Multi-slope-ADC/PCB/bom/BOM-all.csv

Reference | Value | Footprint | Quantity | DNP | Manufacturer | Manufacturer Part Number | Datasheet | Jumper State | Assembly note
C1 | 100n | Capacitor_SMD:C_0805_2012Metric | 1 |  | KYOCERA AVX | 08055C104KAT2A | https://datasheets.kyocera-avx.com/X7RDielectric.pdf
C2 | 100n | Capacitor_SMD:C_0805_2012Metric | 1 |  | KYOCERA AVX | 08055C104KAT2A | https://datasheets.kyocera-avx.com/X7RDielectric.pdf
C3 | 100n | Capacitor_SMD:C_0805_2012Metric | 1 |  | KYOCERA AVX | 08055C104KAT2A | https://datasheets.kyocera-avx.com/X7RDielectric.pdf
C4 | 100n | Capacitor_SMD:C_0805_2012Metric | 1 |  | KYOCERA AVX | 08055C104KAT2A | https://datasheets.kyocera-avx.com/X7RDielectric.pdf
C5 | 100n | Capacitor_SMD:C_0805_2012Metric | 1 |  | KYOCERA AVX | 08055C104KAT2A | https://datasheets.kyocera-avx.com/X7RDielectric.pdf
C6 | 2.2u | Capacitor_SMD:C_0805_2012Metric | 1 | DNP | Samsung Electro-Mechanics | CL21B225KAFNNNE | https://product.samsungsem.com/mlcc/CL21B225KAFNNN.do
C7 | 100u | Capacitor_THT:CP_Radial_D8.0mm_P3.50mm | 1 |  | Panasonic | EEU-EB1J101 | https://industrial.panasonic.com/ww/products/pt/aluminum-cap-lead/models/EEUEB1J101
C8 | 100u | Capacitor_THT:CP_Radial_D8.0mm_P3.50mm | 1 |  | Panasonic | EEU-EB1J101 | https://industrial.panasonic.com/ww/products/pt/aluminum-cap-lead/models/EEUEB1J101
C9 | 100n | Capacitor_SMD:C_0805_2012Metric | 1 |  | KYOCERA AVX | 08055C104KAT2A | https://datasheets.kyocera-avx.com/X7RDielectric.pdf
C10 | 100n | Capacitor_SMD:C_0805_2012Metric | 1 |  | KYOCERA AVX | 08055C104KAT2A | https://datasheets.kyocera-avx.com/X7RDielectric.pdf
C11 | 2.2n | Capacitor_SMD:C_0805_2012Metric | 1 |  | TDK | C2012C0G1H222J085AA | https://product.tdk.com/en/search/capacitor/ceramic/mlcc/info?part_no=C2012C0G1H222J085AA
C12 | 100n | Capacitor_SMD:C_0805_2012Metric | 1 |  | KYOCERA AVX | 08055C104KAT2A | https://datasheets.kyocera-avx.com/X7RDielectric.pdf
C13 | 4.7u | Capacitor_THT:C_Rect_L7.2mm_W7.2mm_P5.00mm_FKS2_FKP2_MKS2_MKP2 | 1 |  | WIMA | MKS2C044701M00KSSD | https://www.wima.de/wp-content/uploads/media/e_WIMA_MKS_2.pdf
C14 | 220p | Capacitor_SMD:C_0805_2012Metric | 1 |  | Samsung Electro-Mechanics | CL21C221JBANNNC | https://product.samsungsem.com/mlcc/CL21C221JBANNN.do
C15 | 22p | Capacitor_SMD:C_0805_2012Metric | 1 |  | Samsung Electro-Mechanics | CL21C220JBANNNC | https://product.samsungsem.com/mlcc/CL21C220JBANNN.do |  | Original assembly: first of two parallel 22pF parts at C15; second part C211. Total 44pF, user confirmed.
C16 | 10n | Capacitor_SMD:C_0805_2012Metric | 1 |  | TDK | CGA4C2C0G1H103J060AA | https://product.tdk.com/en/search/capacitor/ceramic/mlcc/info?part_no=CGA4C2C0G1H103J060AA
C17 | 330p | Capacitor_SMD:C_0805_2012Metric | 1 |  | KEMET | C0805C331J5GACTU | https://content.kemet.com/datasheets/KEM_C1003_C0G_SMD.pdf
C18 | 100n | Capacitor_SMD:C_0805_2012Metric | 1 |  | KYOCERA AVX | 08055C104KAT2A | https://datasheets.kyocera-avx.com/X7RDielectric.pdf
C19 | 100n | Capacitor_SMD:C_0805_2012Metric | 1 |  | KYOCERA AVX | 08055C104KAT2A | https://datasheets.kyocera-avx.com/X7RDielectric.pdf
C20 | 100u | Capacitor_THT:CP_Radial_D8.0mm_P3.50mm | 1 |  | Panasonic | EEU-EB1J101 | https://industrial.panasonic.com/ww/products/pt/aluminum-cap-lead/models/EEUEB1J101
C21 | 220p | Capacitor_SMD:C_0805_2012Metric | 1 |  | Samsung Electro-Mechanics | CL21C221JBANNNC | https://product.samsungsem.com/mlcc/CL21C221JBANNN.do
C22 | 100u | Capacitor_THT:CP_Radial_D8.0mm_P3.50mm | 1 |  | Panasonic | EEU-EB1J101 | https://industrial.panasonic.com/ww/products/pt/aluminum-cap-lead/models/EEUEB1J101
C23 | 100u | Capacitor_THT:CP_Radial_D8.0mm_P3.50mm | 1 |  | Panasonic | EEU-EB1J101 | https://industrial.panasonic.com/ww/products/pt/aluminum-cap-lead/models/EEUEB1J101
C24 | 100n | Capacitor_SMD:C_0805_2012Metric | 1 |  | KYOCERA AVX | 08055C104KAT2A | https://datasheets.kyocera-avx.com/X7RDielectric.pdf
C25 | 100n | Capacitor_SMD:C_0805_2012Metric | 1 |  | KYOCERA AVX | 08055C104KAT2A | https://datasheets.kyocera-avx.com/X7RDielectric.pdf
C26 | 47n | Capacitor_SMD:C_0805_2012Metric | 1 |  | KEMET | C0805C473K3GECAUTO | https://content.kemet.com/datasheets/KEM_C1022_C0G_AUTO_SMD.pdf
C27 | 100n | Capacitor_SMD:C_0805_2012Metric | 1 |  | KYOCERA AVX | 08055C104KAT2A | https://datasheets.kyocera-avx.com/X7RDielectric.pdf
C28 | 47n | Capacitor_SMD:C_0805_2012Metric | 1 |  | KEMET | C0805C473K3GECAUTO | https://content.kemet.com/datasheets/KEM_C1022_C0G_AUTO_SMD.pdf
C29 | 220p | Capacitor_SMD:C_0805_2012Metric | 1 |  | Samsung Electro-Mechanics | CL21C221JBANNNC | https://product.samsungsem.com/mlcc/CL21C221JBANNN.do
C30 | 1n | Capacitor_SMD:C_0805_2012Metric | 1 |  | Wurth Elektronik | 885012007063 | https://www.we-online.com/components/products/datasheet/885012007063.pdf
C31 | 100n | Capacitor_SMD:C_0805_2012Metric | 1 |  | KEMET | C0805C473K3GECAUTO | https://content.kemet.com/datasheets/KEM_C1022_C0G_AUTO_SMD.pdf
C32 | 100n | Capacitor_SMD:C_0805_2012Metric | 1 |  | KYOCERA AVX | 08055C104KAT2A | https://datasheets.kyocera-avx.com/X7RDielectric.pdf
C33 | 100n | Capacitor_SMD:C_0805_2012Metric | 1 |  | KYOCERA AVX | 08055C104KAT2A | https://datasheets.kyocera-avx.com/X7RDielectric.pdf
C34 | 100n | Capacitor_SMD:C_0805_2012Metric | 1 |  | KYOCERA AVX | 08055C104KAT2A | https://datasheets.kyocera-avx.com/X7RDielectric.pdf
C35 | 100n | Capacitor_SMD:C_0805_2012Metric | 1 |  | KYOCERA AVX | 08055C104KAT2A | https://datasheets.kyocera-avx.com/X7RDielectric.pdf
C36 | 100n | Capacitor_SMD:C_0805_2012Metric | 1 |  | KYOCERA AVX | 08055C104KAT2A | https://datasheets.kyocera-avx.com/X7RDielectric.pdf
C37 | 1n | Capacitor_SMD:C_0805_2012Metric | 1 | DNP | Wurth Elektronik | 885012007063 | https://www.we-online.com/components/products/datasheet/885012007063.pdf
C38 | 100n | Capacitor_SMD:C_0805_2012Metric | 1 |  | KYOCERA AVX | 08055C104KAT2A | https://datasheets.kyocera-avx.com/X7RDielectric.pdf
C39 | 100n | Capacitor_SMD:C_0805_2012Metric | 1 |  | KYOCERA AVX | 08055C104KAT2A | https://datasheets.kyocera-avx.com/X7RDielectric.pdf
C40 | 100n | Capacitor_SMD:C_0805_2012Metric | 1 |  | KYOCERA AVX | 08055C104KAT2A | https://datasheets.kyocera-avx.com/X7RDielectric.pdf
C41 | 100n | Capacitor_SMD:C_0805_2012Metric | 1 |  | KYOCERA AVX | 08055C104KAT2A | https://datasheets.kyocera-avx.com/X7RDielectric.pdf
C42 | 100n | Capacitor_SMD:C_0805_2012Metric | 1 |  | KYOCERA AVX | 08055C104KAT2A | https://datasheets.kyocera-avx.com/X7RDielectric.pdf
C43 | 100n | Capacitor_SMD:C_0805_2012Metric | 1 |  | KYOCERA AVX | 08055C104KAT2A | https://datasheets.kyocera-avx.com/X7RDielectric.pdf
C44 | 100u | Capacitor_THT:CP_Radial_D8.0mm_P3.50mm | 1 |  | Panasonic | EEU-EB1J101 | https://industrial.panasonic.com/ww/products/pt/aluminum-cap-lead/models/EEUEB1J101
C45 | 100n | Capacitor_SMD:C_0805_2012Metric | 1 |  | KYOCERA AVX | 08055C104KAT2A | https://datasheets.kyocera-avx.com/X7RDielectric.pdf
C46 | 47n | Capacitor_SMD:C_0805_2012Metric | 1 |  | KEMET | C0805C473K3GECAUTO | https://content.kemet.com/datasheets/KEM_C1022_C0G_AUTO_SMD.pdf
C47 | 10n | Capacitor_SMD:C_0805_2012Metric | 1 |  | TDK | CGA4C2C0G1H103J060AA | https://product.tdk.com/en/search/capacitor/ceramic/mlcc/info?part_no=CGA4C2C0G1H103J060AA
C48 | 100n | Capacitor_SMD:C_0805_2012Metric | 1 |  | KYOCERA AVX | 08055C104KAT2A | https://datasheets.kyocera-avx.com/X7RDielectric.pdf
C49 | 100n | Capacitor_SMD:C_0805_2012Metric | 1 |  | KYOCERA AVX | 08055C104KAT2A | https://datasheets.kyocera-avx.com/X7RDielectric.pdf
C50 | 100n | Capacitor_SMD:C_0805_2012Metric | 1 |  | KYOCERA AVX | 08055C104KAT2A | https://datasheets.kyocera-avx.com/X7RDielectric.pdf
C51 | 100n | Capacitor_SMD:C_0805_2012Metric | 1 |  | KYOCERA AVX | 08055C104KAT2A | https://datasheets.kyocera-avx.com/X7RDielectric.pdf
C201 | 100n | Capacitor_SMD:C_0805_2012Metric | 1 |  | KYOCERA AVX | 08055C104KAT2A | https://datasheets.kyocera-avx.com/X7RDielectric.pdf
C202 | 100u | Capacitor_THT:CP_Radial_D8.0mm_P3.50mm | 1 |  | Panasonic | EEU-EB1J101 | https://industrial.panasonic.com/ww/products/pt/aluminum-cap-lead/models/EEUEB1J101
C203 | 100n | Capacitor_SMD:C_0805_2012Metric | 1 |  | KYOCERA AVX | 08055C104KAT2A | https://datasheets.kyocera-avx.com/X7RDielectric.pdf
C204 | 100u | Capacitor_THT:CP_Radial_D8.0mm_P3.50mm | 1 |  | Panasonic | EEU-EB1J101 | https://industrial.panasonic.com/ww/products/pt/aluminum-cap-lead/models/EEUEB1J101
C205 | 100n | Capacitor_SMD:C_0805_2012Metric | 1 |  | KYOCERA AVX | 08055C104KAT2A | https://datasheets.kyocera-avx.com/X7RDielectric.pdf
C206 | 100u | Capacitor_THT:CP_Radial_D8.0mm_P3.50mm | 1 |  | Panasonic | EEU-EB1J101 | https://industrial.panasonic.com/ww/products/pt/aluminum-cap-lead/models/EEUEB1J101
C207 | 100u | Capacitor_THT:CP_Radial_D8.0mm_P3.50mm | 1 |  | Panasonic | EEU-EB1J101 | https://industrial.panasonic.com/ww/products/pt/aluminum-cap-lead/models/EEUEB1J101
C209 | 100n | Capacitor_SMD:C_0805_2012Metric | 1 |  | KYOCERA AVX | 08055C104KAT2A | https://datasheets.kyocera-avx.com/X7RDielectric.pdf
C210 | 100n | Capacitor_SMD:C_0805_2012Metric | 1 |  | KYOCERA AVX | 08055C104KAT2A | https://datasheets.kyocera-avx.com/X7RDielectric.pdf
C211 | 22p | Capacitor_SMD:C_0805_2012Metric | 1 |  | Samsung Electro-Mechanics | CL21C220JBANNNC | https://product.samsungsem.com/mlcc/CL21C220JBANNN.do |  | Original assembly: second 22pF part physically added in parallel at C15. No dedicated PCB footprint; C15 + C211 = 44pF, user confirmed.
D1 | 12V | Diode_SMD:D_SOD-323 | 1 |  | Diodes Incorporated | DDZ12CSF-7 | https://www.diodes.com/part/view/DDZ12CSF
D3 | 1N4148 | Diode_SMD:D_SOD-323 | 1 |  | onsemi | 1N4148WS | https://www.onsemi.com/pdf/datasheet/1n4148ws-d.pdf
D4 | 5.6V | Diode_SMD:D_SOD-323 | 1 |  | onsemi | MM3Z5V6ST1G | https://www.onsemi.com/download/data-sheet/pdf/mm3z2v4st1-d.pdf
D5 | 1N4148 | Diode_SMD:D_SOD-323 | 1 |  | onsemi | 1N4148WS | https://www.onsemi.com/pdf/datasheet/1n4148ws-d.pdf
D6 | 5.6V | Diode_SMD:D_SOD-323 | 1 |  | onsemi | MM3Z5V6ST1G | https://www.onsemi.com/download/data-sheet/pdf/mm3z2v4st1-d.pdf
D7 | 12V | Diode_SMD:D_SOD-323 | 1 |  | Diodes Incorporated | DDZ12CSF-7 | https://www.diodes.com/part/view/DDZ12CSF
D8 | 1N4148 | Diode_SMD:D_SOD-323 | 1 |  | onsemi | 1N4148WS | https://www.onsemi.com/pdf/datasheet/1n4148ws-d.pdf
D9 | 5.6V | Diode_SMD:D_SOD-323 | 1 |  | onsemi | MM3Z5V6ST1G | https://www.onsemi.com/download/data-sheet/pdf/mm3z2v4st1-d.pdf
D11 | 1N4148 | Diode_SMD:D_SOD-323 | 1 |  | onsemi | 1N4148WS | https://www.onsemi.com/pdf/datasheet/1n4148ws-d.pdf
D12 | 1N4148 | Diode_SMD:D_SOD-323 | 1 |  | onsemi | 1N4148WS | https://www.onsemi.com/pdf/datasheet/1n4148ws-d.pdf
D13 | 1N4148 | Diode_SMD:D_SOD-323 | 1 |  | onsemi | 1N4148WS | https://www.onsemi.com/pdf/datasheet/1n4148ws-d.pdf
D14 | 1N4148 | Diode_SMD:D_SOD-323 | 1 |  | onsemi | 1N4148WS | https://www.onsemi.com/pdf/datasheet/1n4148ws-d.pdf
D15 | BAV199 | Package_TO_SOT_SMD:SOT-23 | 1 |  | onsemi | BAV199LT1G | https://www.onsemi.com/pdf/datasheet/bav199lt1-d.pdf
D18 | 1N4148 | Diode_SMD:D_SOD-323 | 1 |  | onsemi | 1N4148WS | https://www.onsemi.com/pdf/datasheet/1n4148ws-d.pdf
D19 | 1N4148 | Diode_SMD:D_SOD-323 | 1 |  | onsemi | 1N4148WS | https://www.onsemi.com/pdf/datasheet/1n4148ws-d.pdf
D201 | 1N4148 | Diode_SMD:D_SOD-323 | 1 |  | onsemi | 1N4148WS | https://www.onsemi.com/pdf/datasheet/1n4148ws-d.pdf
D202 | 1N4148 | Diode_SMD:D_SOD-323 | 1 |  | onsemi | 1N4148WS | https://www.onsemi.com/pdf/datasheet/1n4148ws-d.pdf
D203 | 1N4148WS |  | 1 |  | onsemi | 1N4148WS | https://www.onsemi.com/pdf/datasheet/1n4148ws-d.pdf |  | Hand-added original Q8 replacement, no dedicated PCB footprint. Connection by original Q8 pads and wire.
D204 | 1N4148WS |  | 1 |  | onsemi | 1N4148WS | https://www.onsemi.com/pdf/datasheet/1n4148ws-d.pdf |  | Hand-added original Q8 replacement, no dedicated PCB footprint. Connection by original Q8 pads and wire.
D205 | 1N4148 |  | 1 |  |  | 1N4148 | https://www.onsemi.com/download/data-sheet/pdf/1n914-d.pdf |  | Original additional 1N4148 near the voltage regulators with long leads: A to +5V, K to +15V. Type and orientation documented by the user on 2026-09-22. Manufacturer and ordering variant unknown; the datasheet is a manufacturer family reference and does not establish an onsemi/TR part.
FB1 | Ferrite | Inductor_SMD:L_0805_2012Metric | 1 |  | TDK | MMZ2012Y152BT000 | https://product.tdk.com/en/system/files/dam/doc/product/emc/emc/beads/catalog/beads_commercial_signal_mmz2012_en.pdf
FB35 | Ferrite | Inductor_SMD:L_0805_2012Metric | 1 |  | TDK | MMZ2012Y152BT000 | https://product.tdk.com/en/system/files/dam/doc/product/emc/emc/beads/catalog/beads_commercial_signal_mmz2012_en.pdf
FB57 | Ferrite | Inductor_SMD:L_0805_2012Metric | 1 |  | TDK | MMZ2012Y152BT000 | https://product.tdk.com/en/system/files/dam/doc/product/emc/emc/beads/catalog/beads_commercial_signal_mmz2012_en.pdf
FB102 | Ferrite | Inductor_SMD:L_0805_2012Metric | 1 |  | TDK | MMZ2012Y152BT000 | https://product.tdk.com/en/system/files/dam/doc/product/emc/emc/beads/catalog/beads_commercial_signal_mmz2012_en.pdf
FB103 | Ferrite | Inductor_SMD:L_0805_2012Metric | 1 |  | TDK | MMZ2012Y152BT000 | https://product.tdk.com/en/system/files/dam/doc/product/emc/emc/beads/catalog/beads_commercial_signal_mmz2012_en.pdf
J1 | UART | Connector_PinHeader_2.54mm:PinHeader_1x04_P2.54mm_Vertical | 1 |  |  |  |  |  | Fitted as explicitly specified by the user; generic pin header with no specific manufacturer or part number.
J2 | Input | Connector_PinHeader_2.54mm:PinHeader_2x05_P2.54mm_Vertical | 1 |  |  |  |  |  | Fitted as explicitly specified by the user; generic pin header with no specific manufacturer or part number.
J3 | ICSP6 | Connector_PinHeader_2.54mm:PinHeader_2x03_P2.54mm_Vertical | 1 |  |  |  |  |  | Fitted as explicitly specified by the user; generic pin header with no specific manufacturer or part number.
J4 | ISCP10 | Connector_PinHeader_2.54mm:PinHeader_2x05_P2.54mm_Vertical | 1 |  |  |  |  |  | Fitted as explicitly specified by the user; generic pin header with no specific manufacturer or part number.
J5 | Power | Connector_PinHeader_2.54mm:PinHeader_1x05_P2.54mm_Vertical | 1 |  |  |  |  |  | Fitted as explicitly specified by the user; generic pin header with no specific manufacturer or part number.
LSP6 | INTX | Connector_PinHeader_2.54mm:PinHeader_1x01_P2.54mm_Vertical | 1 |  |  |  |  |  | Fitted as explicitly specified by the user; generic pin header with no specific manufacturer or part number.
LSP7 | Input+ | Connector_PinHeader_2.54mm:PinHeader_1x01_P2.54mm_Vertical | 1 |  |  |  |  |  | Not fitted (DNP), explicitly confirmed by the user on 2026-10-04.
LSP8 | Input- | Connector_PinHeader_2.54mm:PinHeader_1x01_P2.54mm_Vertical | 1 |  |  |  |  |  | Not fitted (DNP), explicitly confirmed by the user on 2026-10-04.
LSP200 | BIAS | Connector_PinHeader_2.54mm:PinHeader_1x01_P2.54mm_Vertical | 1 |  |  |  |  |  | Fitted as explicitly specified by the user; generic pin header with no specific manufacturer or part number.
Q$2 | MMBFJ310LT1G | Package_TO_SOT_SMD:SOT-23 | 1 | DNP | onsemi | MMBFJ310LT1G | https://www.onsemi.com/download/data-sheet/pdf/mmbfj309lt1-d.pdf
Q1 | BC856A | Package_TO_SOT_SMD:SOT-23 | 1 |  | Nexperia | BC856A,215 | https://assets.nexperia.com/documents/data-sheet/BC856_BC857_BC858.pdf
Q2 | BAS21 | Package_TO_SOT_SMD:SOT-23 | 1 |  | ROHM | BAS21HMFHT116 | https://www.rohm.com/products/diodes/switching-diodes/automotive/bas21hmfh-product |  | Original Q2 position: BAS21 A=pad1,K=pad3. Pad2 externally tied to input copper but internally NC; passive NC pin documents metal only.
Q3 | BC856A | Package_TO_SOT_SMD:SOT-23 | 1 |  | Nexperia | BC856A,215 | https://assets.nexperia.com/documents/data-sheet/BC856_BC857_BC858.pdf
Q4 | BC856A | Package_TO_SOT_SMD:SOT-23 | 1 |  | Nexperia | BC856A,215 | https://assets.nexperia.com/documents/data-sheet/BC856_BC857_BC858.pdf
Q5 | BC856A | Package_TO_SOT_SMD:SOT-23 | 1 |  | Nexperia | BC856A,215 | https://assets.nexperia.com/documents/data-sheet/BC856_BC857_BC858.pdf
Q6 | BC856A | Package_TO_SOT_SMD:SOT-23 | 1 |  | Nexperia | BC856A,215 | https://assets.nexperia.com/documents/data-sheet/BC856_BC857_BC858.pdf
Q7 | BC847C | Package_TO_SOT_SMD:SOT-23 | 1 |  | onsemi | BC847CLT1G | https://www.onsemi.com/download/data-sheet/pdf/bc846alt1-d.pdf
Q9 | BC856A | Package_TO_SOT_SMD:SOT-23 | 1 | DNP | Nexperia | BC856A,215 | https://assets.nexperia.com/documents/data-sheet/BC856_BC857_BC858.pdf
R1 | 4K99 | Resistor_SMD:R_0805_2012Metric | 1 |  | Susumu | RR1220P-4991-D-M | https://www.susumu.co.jp/common/pdf/e_all.pdf
R2 | 4K99 | Resistor_SMD:R_0805_2012Metric | 1 |  | Susumu | RR1220P-4991-D-M | https://www.susumu.co.jp/common/pdf/e_all.pdf
R3 | 2.2K | Resistor_SMD:R_0805_2012Metric | 1 |  | Susumu | RR1220P-222-D | https://www.susumu.co.jp/common/pdf/e_all.pdf
R4 | 1K | Resistor_SMD:R_0805_2012Metric | 1 |  | Susumu | RR1220P-102-D | https://www.susumu.co.jp/common/pdf/e_all.pdf
R5 | 22K | Resistor_SMD:R_0805_2012Metric | 1 |  | Susumu | RR1220P-223-D | https://www.susumu.co.jp/common/pdf/e_all.pdf
R6 | 22K | Resistor_SMD:R_0805_2012Metric | 1 |  | Susumu | RR1220P-223-D | https://www.susumu.co.jp/common/pdf/e_all.pdf
R7 | 100 | Resistor_SMD:R_0805_2012Metric | 1 |  | Susumu | RR1220P-101-D | https://www.susumu.co.jp/common/pdf/e_all.pdf
R8 | 100K | Resistor_SMD:R_0805_2012Metric | 1 |  | Susumu | RR1220P-104-D | https://www.susumu.co.jp/common/pdf/e_all.pdf
R9 | 4K99 | Resistor_SMD:R_0805_2012Metric | 1 |  | Susumu | RR1220P-4991-D-M | https://www.susumu.co.jp/common/pdf/e_all.pdf
R10 | 6.8K | Resistor_SMD:R_0805_2012Metric | 1 |  | Susumu | RR1220P-682-D | https://www.susumu.co.jp/common/pdf/e_all.pdf
R11 | 1K | Resistor_SMD:R_0805_2012Metric | 1 |  | Susumu | RR1220P-102-D | https://www.susumu.co.jp/common/pdf/e_all.pdf
R12 | 4K99 | Resistor_SMD:R_0805_2012Metric | 1 |  | Susumu | RR1220P-4991-D-M | https://www.susumu.co.jp/common/pdf/e_all.pdf
R13 | 47K | Resistor_SMD:R_0805_2012Metric | 1 |  | Susumu | RR1220P-473-D | https://www.susumu.co.jp/common/pdf/e_all.pdf
R14 | 47K | Resistor_SMD:R_0805_2012Metric | 1 |  | Susumu | RR1220P-473-D | https://www.susumu.co.jp/common/pdf/e_all.pdf
R16 | 22K | Resistor_SMD:R_0805_2012Metric | 1 |  | Susumu | RR1220P-223-D | https://www.susumu.co.jp/common/pdf/e_all.pdf
R18 | 330K | Resistor_SMD:R_0805_2012Metric | 1 |  | Susumu | RR1220P-334-D | https://www.susumu.co.jp/common/pdf/e_all.pdf
R19 | 4.7K | Resistor_SMD:R_0805_2012Metric | 1 |  | Susumu | RR1220P-472-D | https://www.susumu.co.jp/common/pdf/e_all.pdf
R20 | 180R | Resistor_SMD:R_0805_2012Metric | 1 |  | Susumu | RR1220P-181-D | https://www.susumu.co.jp/common/pdf/e_all.pdf |  | Original: 180 Ohm fitted, confirmed by the user on 2026-10-04; part type as listed in the Mouser parts list.
R21 | 10R | Resistor_SMD:R_0805_2012Metric | 1 |  | Susumu | RR1220Q-100-D | https://www.susumu.co.jp/common/pdf/e_all.pdf
R22 | 4.7K | Resistor_SMD:R_0805_2012Metric | 1 |  | Susumu | RR1220P-472-D | https://www.susumu.co.jp/common/pdf/e_all.pdf
R24 | 22K | Resistor_SMD:R_0805_2012Metric | 1 |  | Susumu | RR1220P-223-D | https://www.susumu.co.jp/common/pdf/e_all.pdf
R25 | 330K | Resistor_SMD:R_0805_2012Metric | 1 |  | Susumu | RR1220P-334-D | https://www.susumu.co.jp/common/pdf/e_all.pdf
R26 | 10R | Resistor_SMD:R_0805_2012Metric | 1 |  | Susumu | RR1220Q-100-D | https://www.susumu.co.jp/common/pdf/e_all.pdf
R27 | 39R | Resistor_SMD:R_0805_2012Metric | 1 |  | Susumu | RR1220Q-390-D | https://www.susumu.co.jp/common/pdf/e_all.pdf
R28 | 470R | Resistor_SMD:R_0805_2012Metric | 1 |  | Susumu | RR1220P-471-D | https://www.susumu.co.jp/common/pdf/e_all.pdf
R29 | 100R | Resistor_SMD:R_0805_2012Metric | 1 |  | Susumu | RR1220P-101-D | https://www.susumu.co.jp/common/pdf/e_all.pdf
R30 | OPT | Resistor_SMD:R_0805_2012Metric | 1 | DNP |  |  | ~
R31 | 100R | Resistor_SMD:R_0805_2012Metric | 1 |  | Susumu | RR1220P-101-D | https://www.susumu.co.jp/common/pdf/e_all.pdf
R32 | 100R | Resistor_SMD:R_0805_2012Metric | 1 |  | Susumu | RR1220P-101-D | https://www.susumu.co.jp/common/pdf/e_all.pdf
R33 | 10R | Resistor_SMD:R_0805_2012Metric | 1 |  | Susumu | RR1220Q-100-D | https://www.susumu.co.jp/common/pdf/e_all.pdf
R34 | 68K | Resistor_SMD:R_0805_2012Metric | 1 |  | Susumu | RR1220P-683-D | https://www.susumu.co.jp/common/pdf/e_all.pdf
R35 | 4K99 | Resistor_SMD:R_0805_2012Metric | 1 |  | Susumu | RR1220P-4991-D-M | https://www.susumu.co.jp/common/pdf/e_all.pdf
R36 | 22K | Resistor_SMD:R_0805_2012Metric | 1 |  | Susumu | RR1220P-223-D | https://www.susumu.co.jp/common/pdf/e_all.pdf
R37 | 1K | Resistor_SMD:R_0805_2012Metric | 1 |  | Susumu | RR1220P-102-D | https://www.susumu.co.jp/common/pdf/e_all.pdf
R38 | 10K | Resistor_SMD:R_0805_2012Metric | 1 |  | Susumu | RR1220P-103-D | https://www.susumu.co.jp/common/pdf/e_all.pdf
R39 | 0R | Resistor_SMD:R_0805_2012Metric | 1 | DNP |  |  | ~
R40 | 10K | Resistor_SMD:R_0805_2012Metric | 1 |  | Susumu | RR1220P-103-D | https://www.susumu.co.jp/common/pdf/e_all.pdf
R43 | 4.7K | Resistor_SMD:R_0805_2012Metric | 1 |  | Susumu | RR1220P-472-D | https://www.susumu.co.jp/common/pdf/e_all.pdf
R44 | 39R | Resistor_SMD:R_0805_2012Metric | 1 |  | Susumu | RR1220Q-390-D | https://www.susumu.co.jp/common/pdf/e_all.pdf
R45 | 22K | Resistor_SMD:R_0805_2012Metric | 1 |  | Susumu | RR1220P-223-D | https://www.susumu.co.jp/common/pdf/e_all.pdf
R46 | 120K | Resistor_SMD:R_0805_2012Metric | 1 |  | Susumu | RR1220P-124-D | https://www.susumu.co.jp/common/pdf/e_all.pdf
R47 | Jumper (closed) | Jumper:SolderJumper-2_P1.3mm_Open_RoundedPad1.0x1.5mm | 1 |  |  |  | ~ | closed
R48 | 22K | Resistor_SMD:R_0805_2012Metric | 1 |  | Susumu | RR1220P-223-D | https://www.susumu.co.jp/common/pdf/e_all.pdf
R49 | 22K | Resistor_SMD:R_0805_2012Metric | 1 |  | Susumu | RR1220P-223-D | https://www.susumu.co.jp/common/pdf/e_all.pdf
R50 | 47K | Resistor_SMD:R_0805_2012Metric | 1 |  | Susumu | RR1220P-473-D | https://www.susumu.co.jp/common/pdf/e_all.pdf
R51 | 10K | Resistor_SMD:R_0805_2012Metric | 1 |  | Susumu | RR1220P-103-D | https://www.susumu.co.jp/common/pdf/e_all.pdf
R52 | 1K | Resistor_SMD:R_0805_2012Metric | 1 |  | Susumu | RR1220P-102-D | https://www.susumu.co.jp/common/pdf/e_all.pdf
R53 | 100R | Resistor_SMD:R_0805_2012Metric | 1 |  | Susumu | RR1220P-101-D | https://www.susumu.co.jp/common/pdf/e_all.pdf
R54 | 470R | Resistor_SMD:R_0805_2012Metric | 1 |  | Susumu | RR1220P-471-D | https://www.susumu.co.jp/common/pdf/e_all.pdf
R55 | 22K | Resistor_SMD:R_0805_2012Metric | 1 |  | Susumu | RR1220P-223-D | https://www.susumu.co.jp/common/pdf/e_all.pdf
R56 | 220K | Resistor_SMD:R_0805_2012Metric | 1 |  | Susumu | RR1220P-224-D | https://www.susumu.co.jp/common/pdf/e_all.pdf
R57 | 39R | Resistor_SMD:R_0805_2012Metric | 1 |  | Susumu | RR1220Q-390-D | https://www.susumu.co.jp/common/pdf/e_all.pdf
R58 | 10K | Resistor_SMD:R_0805_2012Metric | 1 |  | Susumu | RR1220P-103-D | https://www.susumu.co.jp/common/pdf/e_all.pdf
R59 | 39R | Resistor_SMD:R_0805_2012Metric | 1 |  | Susumu | RR1220Q-390-D | https://www.susumu.co.jp/common/pdf/e_all.pdf
R60 | 105K | Resistor_SMD:R_0805_2012Metric | 1 |  | Susumu | RR1220P-1053-D-M | https://www.susumu.co.jp/common/pdf/e_all.pdf
R61 | 470K | Resistor_SMD:R_0805_2012Metric | 1 |  | Susumu | RR1220P-474-D | https://www.susumu.co.jp/common/pdf/e_all.pdf
R62 | 39R | Resistor_SMD:R_0805_2012Metric | 1 |  | Susumu | RR1220Q-390-D | https://www.susumu.co.jp/common/pdf/e_all.pdf
R63 | 1K | Resistor_SMD:R_0805_2012Metric | 1 |  | Susumu | RR1220P-102-D | https://www.susumu.co.jp/common/pdf/e_all.pdf
R64 | 4.7K | Resistor_SMD:R_0805_2012Metric | 1 |  | Susumu | RR1220P-472-D | https://www.susumu.co.jp/common/pdf/e_all.pdf
R65 | 22K | Resistor_SMD:R_0805_2012Metric | 1 |  | Susumu | RR1220P-223-D | https://www.susumu.co.jp/common/pdf/e_all.pdf
R66 | 10R | Resistor_SMD:R_0805_2012Metric | 1 |  | Susumu | RR1220Q-100-D | https://www.susumu.co.jp/common/pdf/e_all.pdf
R67 | OPT | Resistor_SMD:R_0805_2012Metric | 1 | DNP |  |  | ~
R68 | 1K | Resistor_SMD:R_0805_2012Metric | 1 |  | Susumu | RR1220P-102-D | https://www.susumu.co.jp/common/pdf/e_all.pdf
R69 | 22K | Resistor_SMD:R_0805_2012Metric | 1 |  | Susumu | RR1220P-223-D | https://www.susumu.co.jp/common/pdf/e_all.pdf
R70 | 39R | Resistor_SMD:R_0805_2012Metric | 1 |  | Susumu | RR1220Q-390-D | https://www.susumu.co.jp/common/pdf/e_all.pdf
R71 | 22K | Resistor_SMD:R_0805_2012Metric | 1 |  | Susumu | RR1220P-223-D | https://www.susumu.co.jp/common/pdf/e_all.pdf
R72 | 22K | Resistor_SMD:R_0805_2012Metric | 1 |  | Susumu | RR1220P-223-D | https://www.susumu.co.jp/common/pdf/e_all.pdf
R73 | 22K | Resistor_SMD:R_0805_2012Metric | 1 |  | Susumu | RR1220P-223-D | https://www.susumu.co.jp/common/pdf/e_all.pdf
R75 | 4.7M | Resistor_SMD:R_0805_2012Metric | 1 |  | TT Electronics | GWCR0805-4M7FT5 | https://www.ttelectronics.com/TTElectronics/media/ProductFiles/Datasheet/gwcr.pdf
R76 | 180K | Resistor_SMD:R_0805_2012Metric | 1 |  | Susumu | RR1220P-184-D | https://www.susumu.co.jp/common/pdf/e_all.pdf
R77 | 15K | Resistor_SMD:R_0805_2012Metric | 1 |  | Susumu | RR1220P-153-D | https://www.susumu.co.jp/common/pdf/e_all.pdf
R78 | 470R | Resistor_SMD:R_0805_2012Metric | 1 |  | Susumu | RR1220P-471-D | https://www.susumu.co.jp/common/pdf/e_all.pdf
R79 | 220R | Resistor_SMD:R_0805_2012Metric | 1 |  | Susumu | RR1220P-221-D | https://www.susumu.co.jp/common/pdf/e_all.pdf
R83 | 4.7M | Resistor_SMD:R_0805_2012Metric | 1 |  | TT Electronics | GWCR0805-4M7FT5 | https://www.ttelectronics.com/TTElectronics/media/ProductFiles/Datasheet/gwcr.pdf
R84 | Jumper (open) | Jumper:SolderJumper-2_P1.3mm_Open_RoundedPad1.0x1.5mm | 1 |  |  |  | ~ | open
R85 | 3.3K | Resistor_SMD:R_0805_2012Metric | 1 | DNP | Susumu | RR1220P-332-D | https://www.susumu.co.jp/common/pdf/e_all.pdf
R86 | 4.7K | Resistor_SMD:R_0805_2012Metric | 1 | DNP | Susumu | RR1220P-472-D | https://www.susumu.co.jp/common/pdf/e_all.pdf
R87 | 10K | Resistor_SMD:R_0805_2012Metric | 1 |  | Susumu | RR1220P-103-D | https://www.susumu.co.jp/common/pdf/e_all.pdf
R90 | 22K | Resistor_SMD:R_0805_2012Metric | 1 | DNP | Susumu | RR1220P-223-D | https://www.susumu.co.jp/common/pdf/e_all.pdf
R91 | 22K | Resistor_SMD:R_0805_2012Metric | 1 |  | Susumu | RR1220P-223-D | https://www.susumu.co.jp/common/pdf/e_all.pdf
R92 | 100R | Resistor_SMD:R_0805_2012Metric | 1 |  | Susumu | RR1220P-101-D | https://www.susumu.co.jp/common/pdf/e_all.pdf
R98 | 10R | Resistor_SMD:R_0805_2012Metric | 1 |  | Susumu | RR1220Q-100-D | https://www.susumu.co.jp/common/pdf/e_all.pdf
R99 | 4.7K | Resistor_SMD:R_0805_2012Metric | 1 |  | Susumu | RR1220P-472-D | https://www.susumu.co.jp/common/pdf/e_all.pdf
R101 | 10R | Resistor_SMD:R_0805_2012Metric | 1 |  | Susumu | RR1220Q-100-D | https://www.susumu.co.jp/common/pdf/e_all.pdf
R201 | 39R | Resistor_SMD:R_0805_2012Metric | 1 |  | Susumu | RR1220Q-390-D | https://www.susumu.co.jp/common/pdf/e_all.pdf
R202 | 330K | Resistor_SMD:R_0805_2012Metric | 1 |  | Susumu | RR1220P-334-D | https://www.susumu.co.jp/common/pdf/e_all.pdf
R203 | Jumper (closed) | Jumper:SolderJumper-2_P1.3mm_Open_RoundedPad1.0x1.5mm | 1 |  |  |  | ~ | closed
R204 | 220R | Resistor_SMD:R_0805_2012Metric | 1 |  | Susumu | RR1220P-221-D | https://www.susumu.co.jp/common/pdf/e_all.pdf
R205 | 220R | Resistor_SMD:R_0805_2012Metric | 1 |  | Susumu | RR1220P-221-D | https://www.susumu.co.jp/common/pdf/e_all.pdf
R206 | 220R | Resistor_SMD:R_0805_2012Metric | 1 |  | Susumu | RR1220P-221-D | https://www.susumu.co.jp/common/pdf/e_all.pdf
R207 | 220R | Resistor_SMD:R_0805_2012Metric | 1 |  | Susumu | RR1220P-221-D | https://www.susumu.co.jp/common/pdf/e_all.pdf
R208 | 220R | Resistor_SMD:R_0805_2012Metric | 1 |  | Susumu | RR1220P-221-D | https://www.susumu.co.jp/common/pdf/e_all.pdf
R209 | 220R | Resistor_SMD:R_0805_2012Metric | 1 |  | Susumu | RR1220P-221-D | https://www.susumu.co.jp/common/pdf/e_all.pdf
R210 | 220R | Resistor_SMD:R_0805_2012Metric | 1 |  | Susumu | RR1220P-221-D | https://www.susumu.co.jp/common/pdf/e_all.pdf
R211 | Jumper (closed) | Jumper:SolderJumper-2_P1.3mm_Open_RoundedPad1.0x1.5mm | 1 |  |  |  | ~ | closed
R212 | 22K |  | 1 |  |  |  |  |  | Original 22 kOhm resistor from the D203/D204 midpoint to GNDS. General purpose as specified by the user; no specific manufacturer or part number.
R213 | 4.7K |  | 1 |  |  |  |  |  | Original R15 replacement circuit with three 4.7 kOhm resistors, confirmed by the user on 2026-10-04. General purpose, with no specific manufacturer or part number. Mounted at the original R15 pads.
R214 | 4.7K |  | 1 |  |  |  |  |  | Original R15 replacement circuit with three 4.7 kOhm resistors, confirmed by the user on 2026-10-04. General purpose, with no specific manufacturer or part number. Mounted at the original R15 pads.
R215 | 4.7K |  | 1 |  |  |  |  |  | Original R15 replacement circuit with three 4.7 kOhm resistors, confirmed by the user on 2026-10-04. General purpose, with no specific manufacturer or part number. Mounted at the original R15 pads.
RN201 | 10K | Package_SO:MSOP-8_3x3mm_P0.65mm | 1 |  | Vishay | MORNTA1002AT5 | https://www.vishay.com/docs/60129/morn.pdf |  | PCB pad9 is guard copper, no MORN terminal
RN202 | 25K | Package_SO:MSOP-8_3x3mm_P0.65mm | 1 |  | Vishay | MORNTA2502AT5 | https://www.vishay.com/docs/60129/morn.pdf |  | PCB pad9 is guard copper, no MORN terminal
RN203 | 25K | Package_SO:MSOP-8_3x3mm_P0.65mm | 1 |  | Vishay | MORNTA2502AT5 | https://www.vishay.com/docs/60129/morn.pdf |  | PCB pad9 is guard copper, no MORN terminal
U$3 | ATmega168A/PA/328P | Package_DIP:DIP-28_W7.62mm_Socket_LongPads | 1 |  | Microchip | ATmega48A/48PA/88A/88PA/168A/168PA/328/328P - PU | https://ww1.microchip.com/downloads/en/DeviceDoc/ATmega48A-PA-88A-PA-168A-PA-328-P-DS-DS40002061B.pdf |  | Currently fitted: ATmega168A; compatible family requested by user
U1 | OPA172 | Package_SO:SOIC-8_3.9x4.9mm_P1.27mm | 1 | DNP | Texas Instruments | OPA172IDR | https://www.ti.com/lit/ds/symlink/opa172.pdf
U2 | OPA172 | Package_SO:SOIC-8_3.9x4.9mm_P1.27mm | 1 |  | Texas Instruments | OPA172IDR | https://www.ti.com/lit/ds/symlink/opa172.pdf
U3 | UA7805 | Package_TO_SOT_THT:TO-220-3_Vertical | 1 |  | Texas Instruments | UA7805CKCT | https://www.ti.com/lit/ds/symlink/ua78.pdf
U4 | NE5534D | Package_SO:SOIC-8_3.9x4.9mm_P1.27mm | 1 |  | Texas Instruments | NE5534DRE4 | https://www.ti.com/lit/ds/symlink/ne5534.pdf
U5 | SN74LV4053A | Package_SO:SOIC-16_3.9x9.9mm_P1.27mm | 1 |  | Texas Instruments | SN74LV4053ADR | https://www.ti.com/lit/ds/symlink/sn74lv4053a.pdf
U6 | LM399AH | Package_TO_SOT_THT:TO-46-4 | 1 |  | Analog Devices / Linear Technology | LM399AH | https://www.analog.com/media/en/technical-documentation/data-sheets/lm199-lm399.pdf |  | Original: LM399AH, confirmed by the user on 2026-10-04. No unconfirmed package or RoHS ordering suffix.
U7 | DG408 | Package_SO:SOIC-16_3.9x9.9mm_P1.27mm | 1 |  | Vishay | DG408DY-E3 | https://www.vishay.com/docs/70062/dg408.pdf
U8 | OP07 | Package_SO:SOIC-8_3.9x4.9mm_P1.27mm | 1 |  | Texas Instruments | OP07CDR | https://www.ti.com/lit/ds/symlink/op07.pdf
U9 | OP07 | Package_SO:SOIC-8_3.9x4.9mm_P1.27mm | 1 |  | Texas Instruments | OP07CDR | https://www.ti.com/lit/ds/symlink/op07.pdf
U10 | LM393 | Package_SO:SOIC-8_3.9x4.9mm_P1.27mm | 1 |  | Texas Instruments | LM393ADRG4 | https://www.ti.com/lit/ds/symlink/lm393a.pdf
U11 | OPA145 | Package_SO:SOIC-8_3.9x4.9mm_P1.27mm | 1 |  | Texas Instruments | OPA145IDR | https://www.ti.com/lit/ds/symlink/opa145.pdf
U12 | OPA145 | Package_SO:SOIC-8_3.9x4.9mm_P1.27mm | 1 |  | Texas Instruments | OPA145IDR | https://www.ti.com/lit/ds/symlink/opa145.pdf
U13 | MCP6002 | Package_SO:SOIC-8_3.9x4.9mm_P1.27mm | 1 |  | Microchip | MCP6002T-I/SN | https://ww1.microchip.com/downloads/aemDocuments/documents/MSLD/ProductDocuments/DataSheets/MCP6001-1R-1U-2-4-1-MHz-Low-Power-Op-Amp-DS20001733L.pdf
U14 | UA7815 | Package_TO_SOT_THT:TO-220-3_Vertical | 1 |  | Texas Instruments | UA7815CKCT | https://www.ti.com/lit/ds/symlink/ua78.pdf
U15 | MC7915 | Package_TO_SOT_THT:TO-220-3_Vertical | 1 |  | onsemi | MC7915ACTG | https://www.onsemi.com/download/data-sheet/pdf/mc7900-d.pdf
U16 | LTC2057 | Package_SO:SOIC-8_3.9x4.9mm_P1.27mm | 1 | DNP | Analog Devices | LTC2057IS8#PBF | https://www.analog.com/en/products/ltc2057.html
U17 | 74HC74 | Package_SO:SOIC-14_3.9x8.7mm_P1.27mm | 1 |  | Nexperia | 74HC74D,653 | https://assets.nexperia.com/documents/data-sheet/74HC_HCT74.pdf |  | Original: HC74 confirmed by the user; 74HC74D,653 as listed in the Mouser parts list. Later 2026 modifications are not included.
U18 | OPA197 | Package_SO:SOIC-8_3.9x4.9mm_P1.27mm | 1 |  | Texas Instruments | OPA197IDR | https://www.ti.com/lit/ds/symlink/opa197.pdf
U19 | OPA172 | Package_SO:SOIC-8_3.9x4.9mm_P1.27mm | 1 |  | Texas Instruments | OPA172IDR | https://www.ti.com/lit/ds/symlink/opa172.pdf
U20 | DG419LDY | Package_SO:SOIC-8_3.9x4.9mm_P1.27mm | 1 | DNP | Analog Devices | DG419LDY+ | https://www.analog.com/en/products/dg419l.html
U21 | OP07 | Package_SO:SOIC-8_3.9x4.9mm_P1.27mm | 1 | DNP | Texas Instruments | OP07CDR | https://www.ti.com/lit/ds/symlink/op07.pdf
U202 | MCP4921 | Package_SO:SOIC-8_3.9x4.9mm_P1.27mm | 1 | DNP | Microchip | MCP4921-E/SN | https://www.microchip.com/en-us/product/MCP4921
U204 | ADuM1201AR | Package_SO:SOIC-8_3.9x4.9mm_P1.27mm | 1 |  | Analog Devices | ADUM1201ARZ-RL7 | https://www.analog.com/media/en/technical-documentation/data-sheets/adum1200_1201.pdf
X1 | 12MHz | Oscillator:Oscillator_DIP-14 | 1 |  |  |  |  |  | Generic 12 MHz oscillator with no specific part type. Original DIP14 pin assignment 1/7/8/14 retained; manufacturer and part number unspecified.
