Multi-slope-ADC/PCB/docs/Schematic.pdf

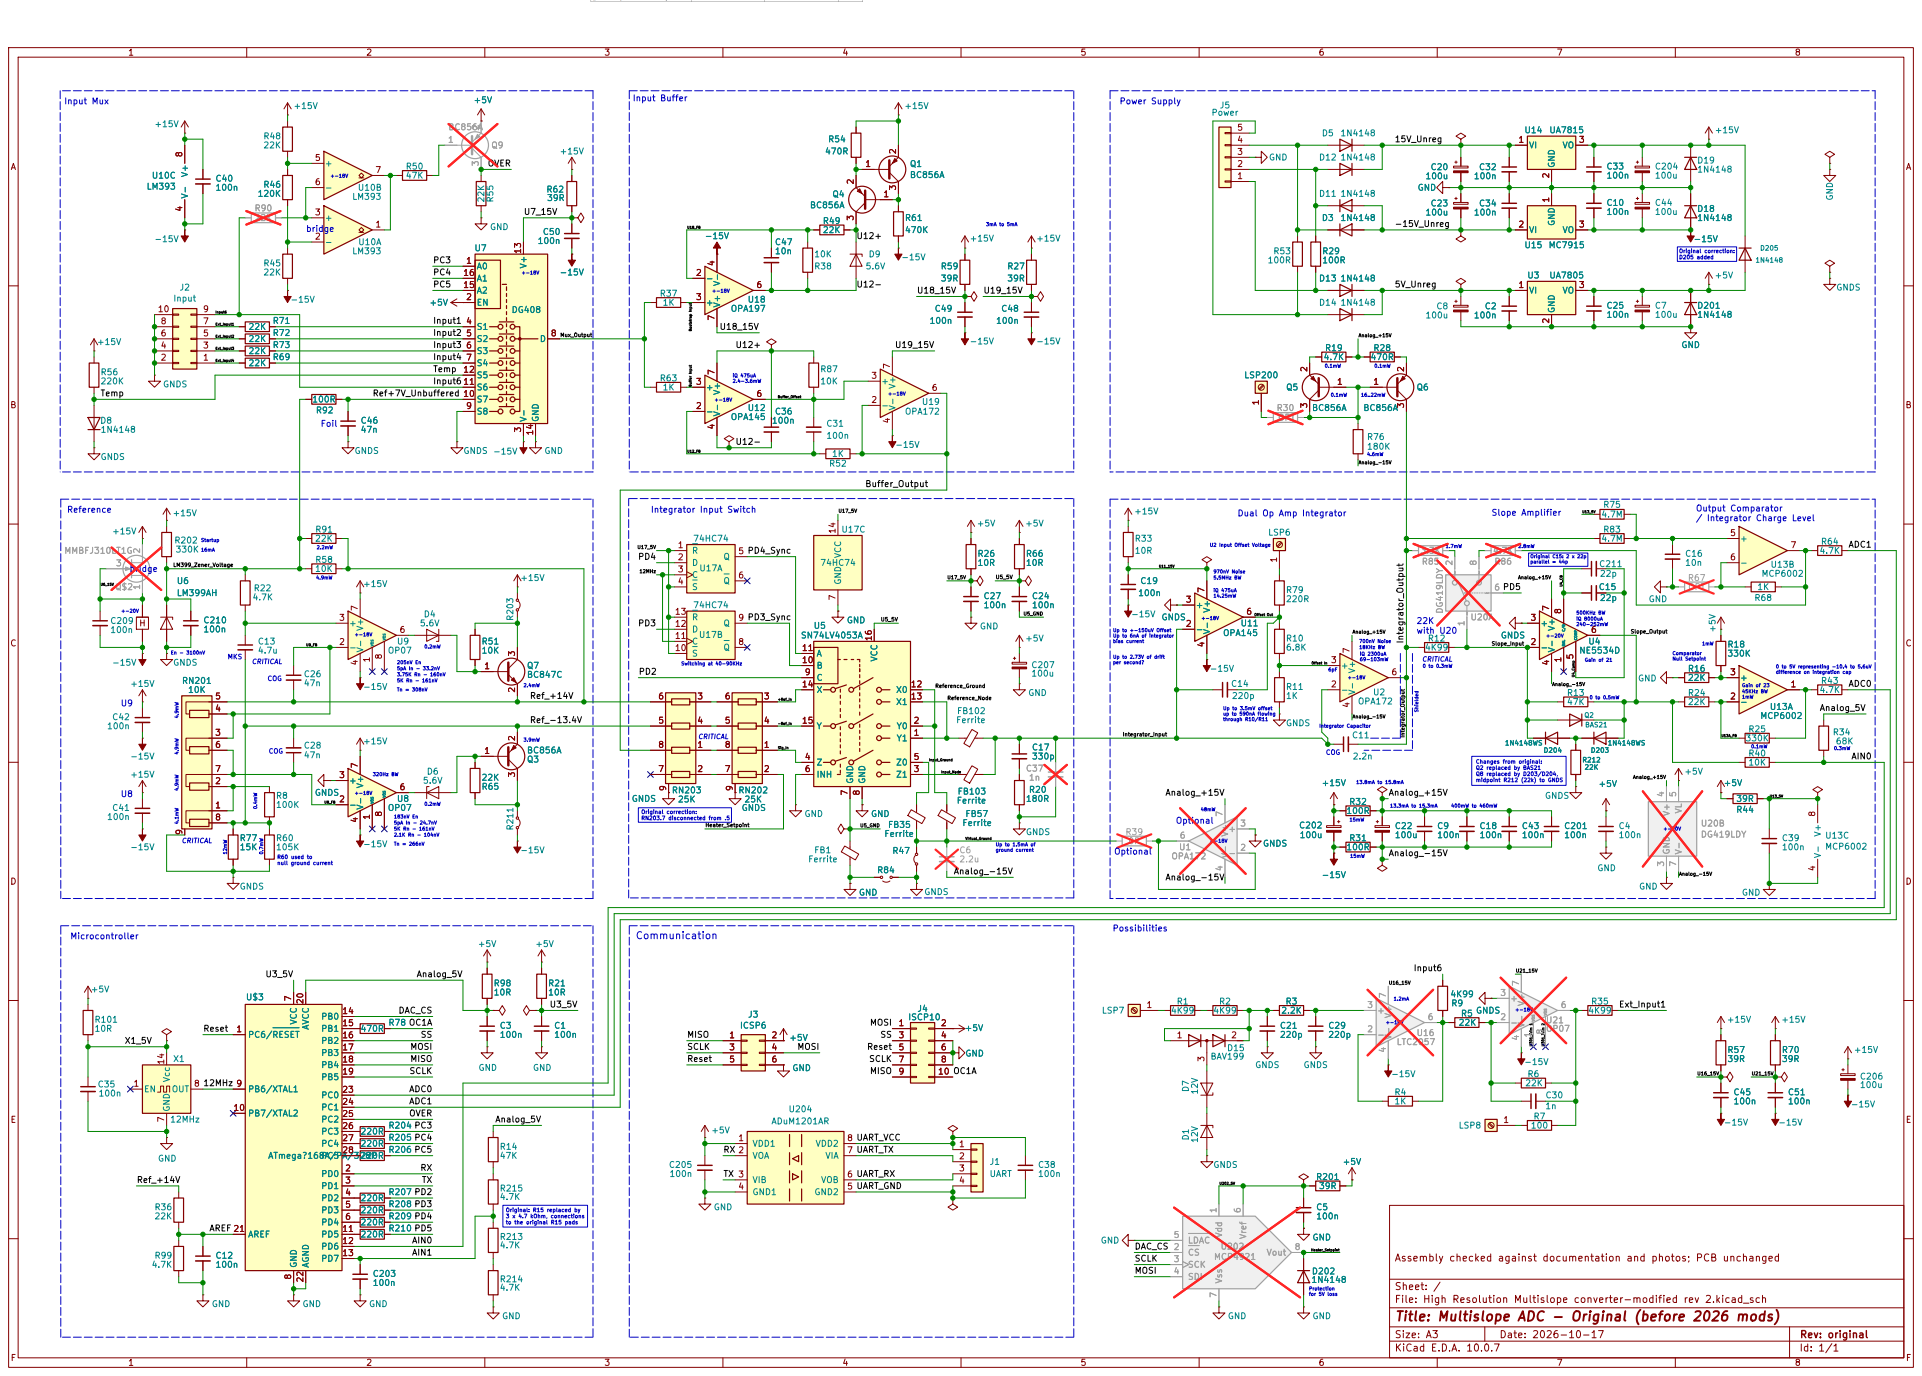
[picture p9: page 1]

6 | 5 Ext_Input2 | | Input2 | Mux_Output Ext_Input1 S2 5 S2 5

4 | 3 Ext_Input3 | R73 22K | Input3 | S3 6

Integrator Input Switch Microcontroller

970nV Noise Dual Op Amp Integrator

/ Integrator Charge Level Original C15: 2 x 22p

0 to 5V representing -10.4 to 5.6uV difference on integration cap

Original correction: RN203.7 disconnected from .5

Original: R15 replaced by 3 x 4.7 kOhm, connections
to the original R15 pads

Assembly checked against documentation and photos; PCB unchanged

Sheet: /
File: High Resolution Multislope converter-modified rev 2.kicad_sch
Title: Multislope ADC - Original (before 2026 mods)

Size: A3 | Rev: original | F Date: 2026-10-17
KiCad E.D.A. 10.0.7 | Id: 1/1
