Multi-slope-ADC/PCB/docs/PCB.pdf

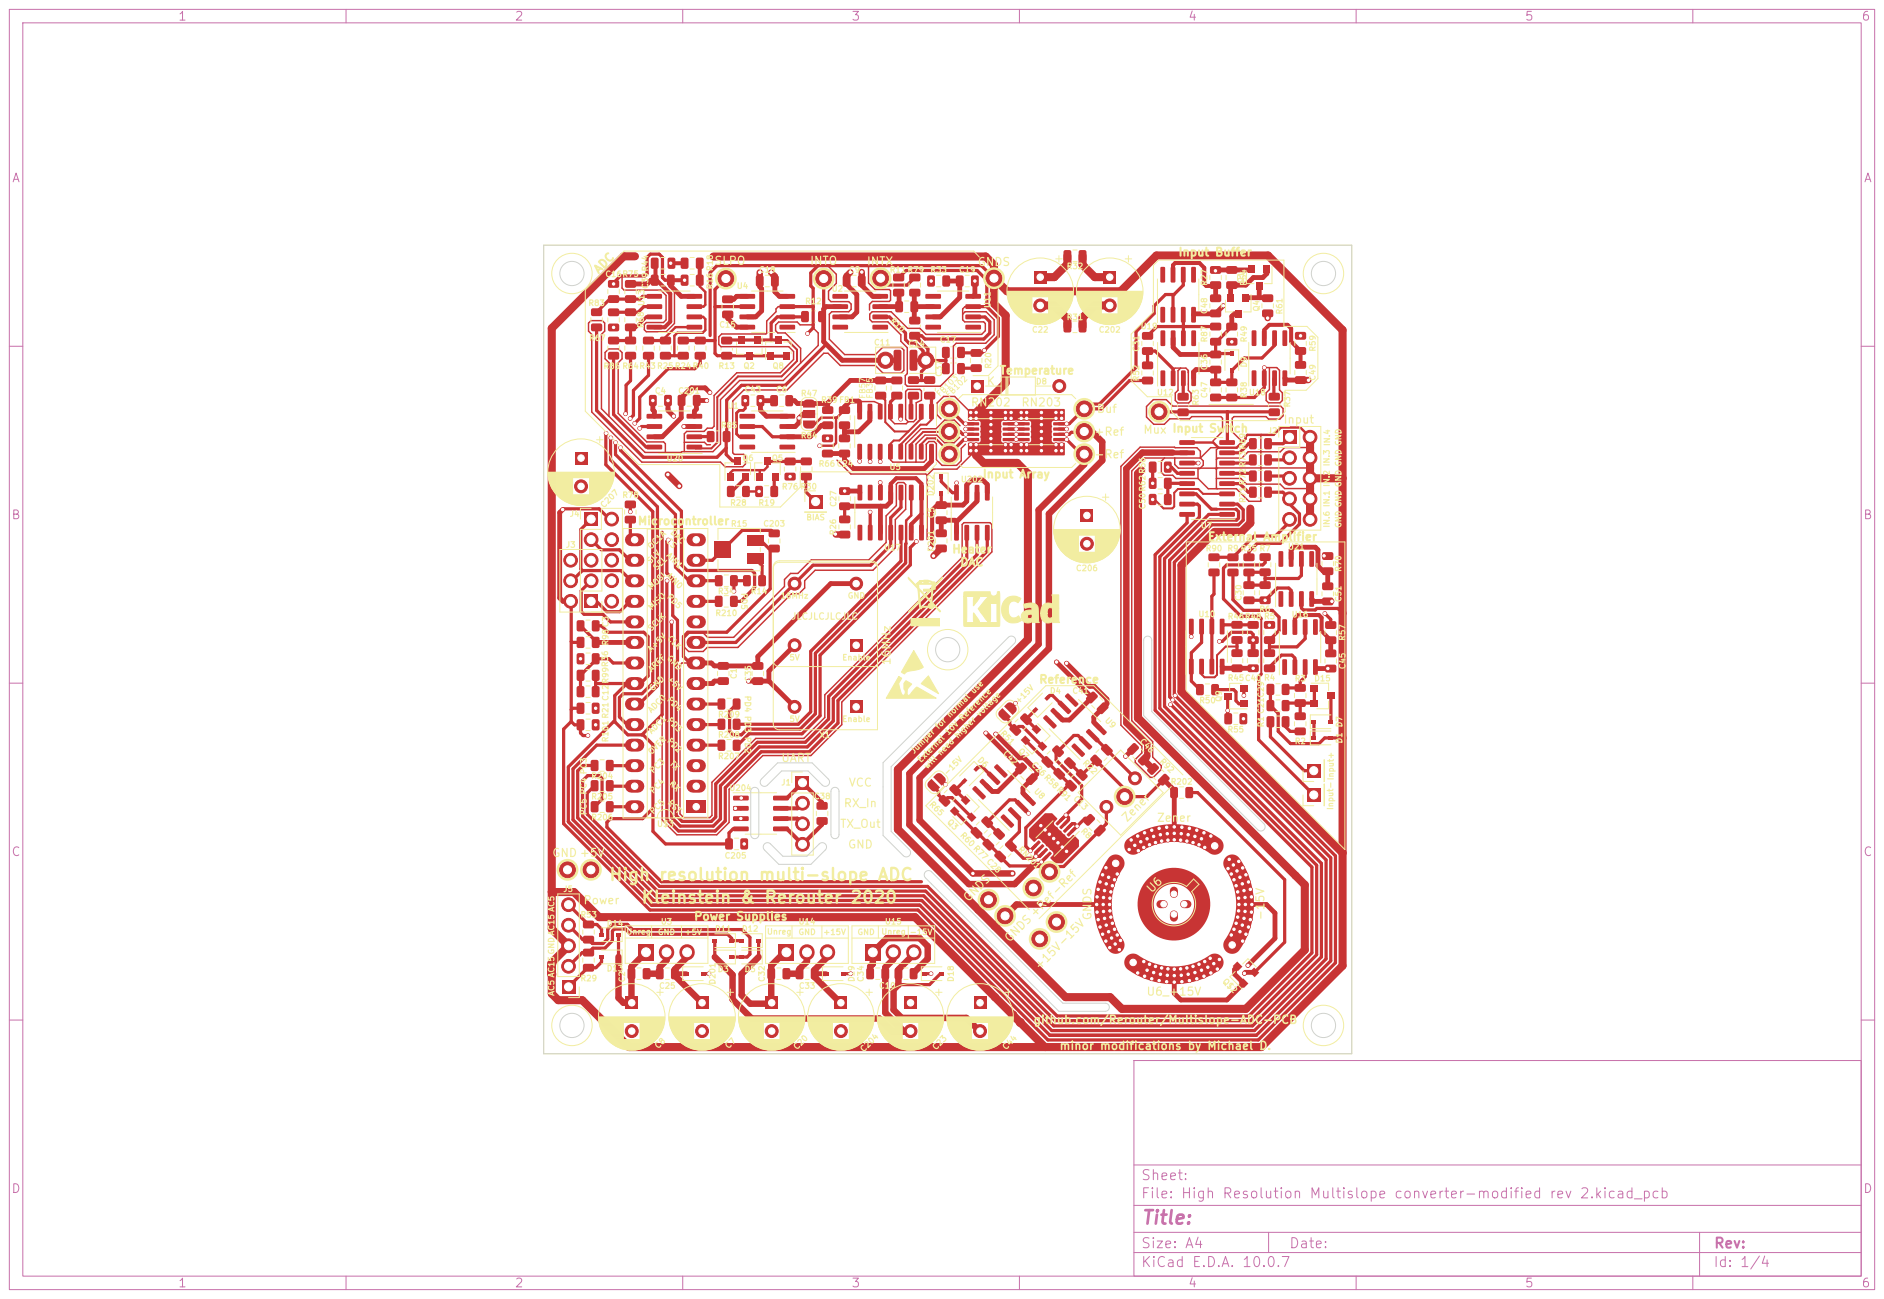
[picture p10: page 1]

Input Buffer External Amplifier ADC

High resolution multi-slope ADC

Sheet:
File: High Resolution Multislope converter-modified rev 2.kicad_pcb
Title:

Size: A4 | Rev:
KiCad E.D.A. 10.0.7 | Id: 1/4

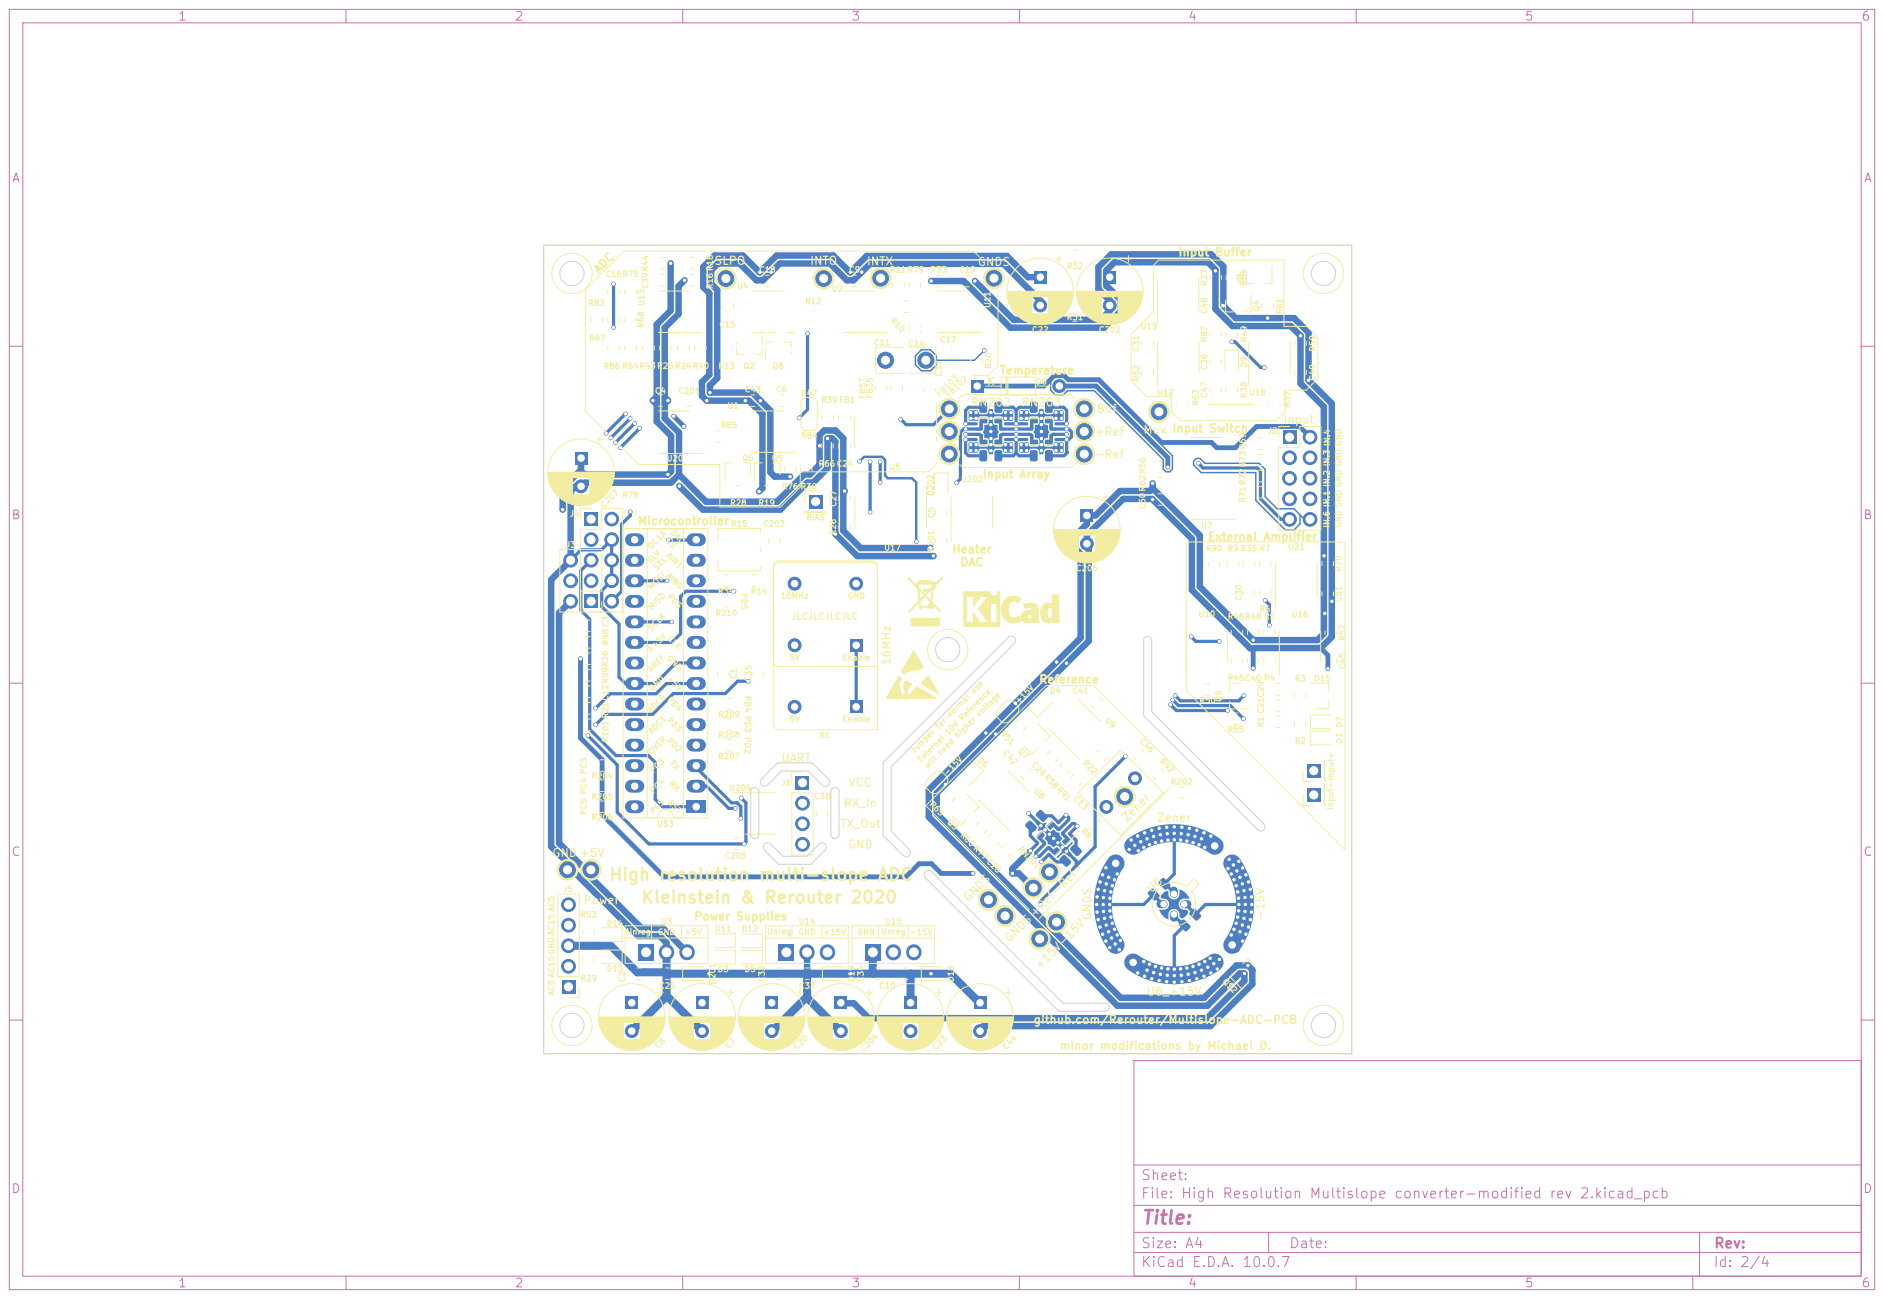
[picture p11: page 2]

Input Buffer External Amplifier ADC

High resolution multi-slope ADC

Sheet:
File: High Resolution Multislope converter-modified rev 2.kicad_pcb
Title:

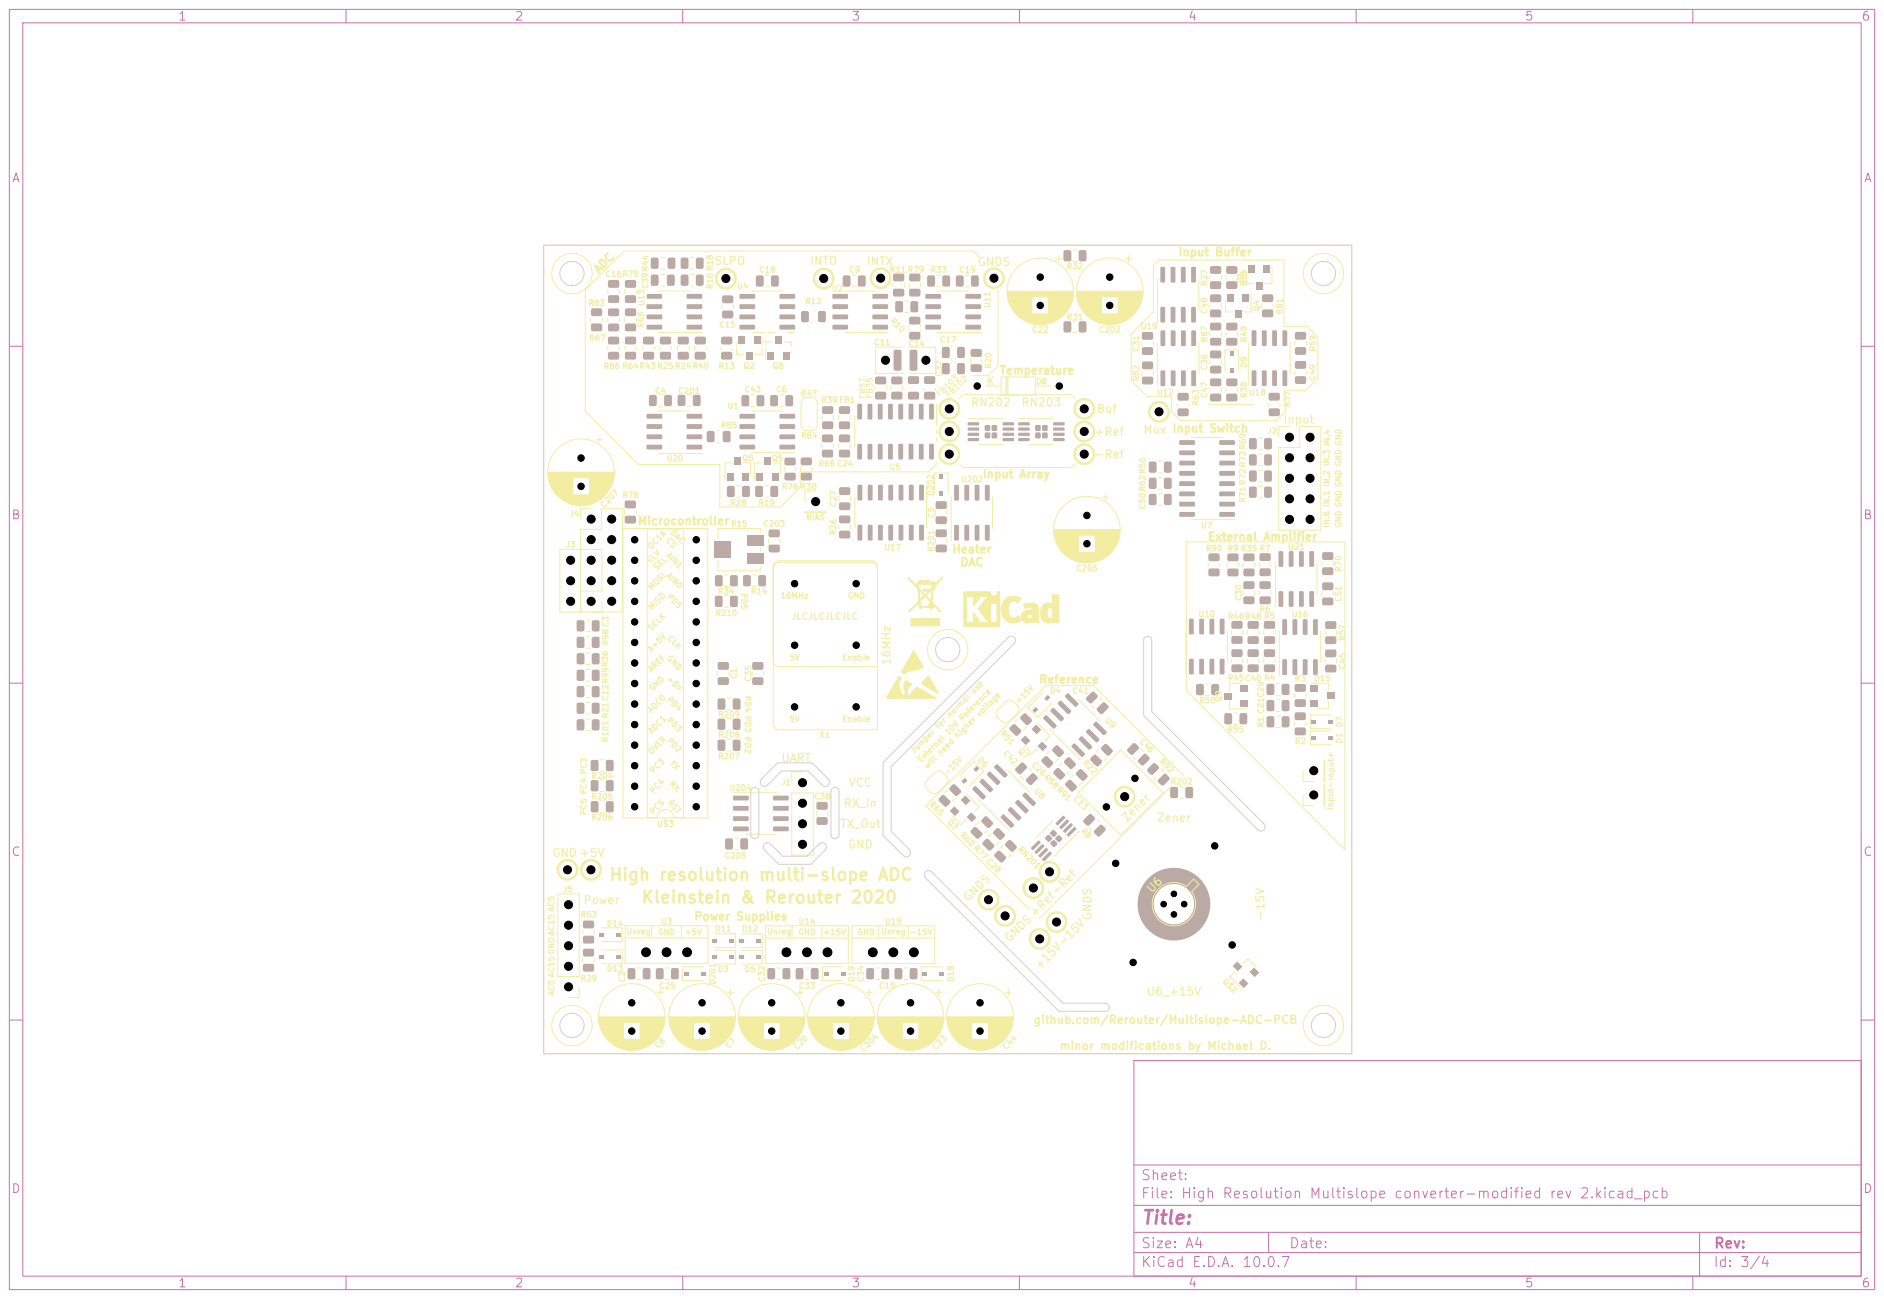
[picture p12: page 3]

Input Buffer External Amplifier ADC

High resolution multi-slope ADC

Sheet:
File: High Resolution Multislope converter-modified rev 2.kicad_pcb
Title:

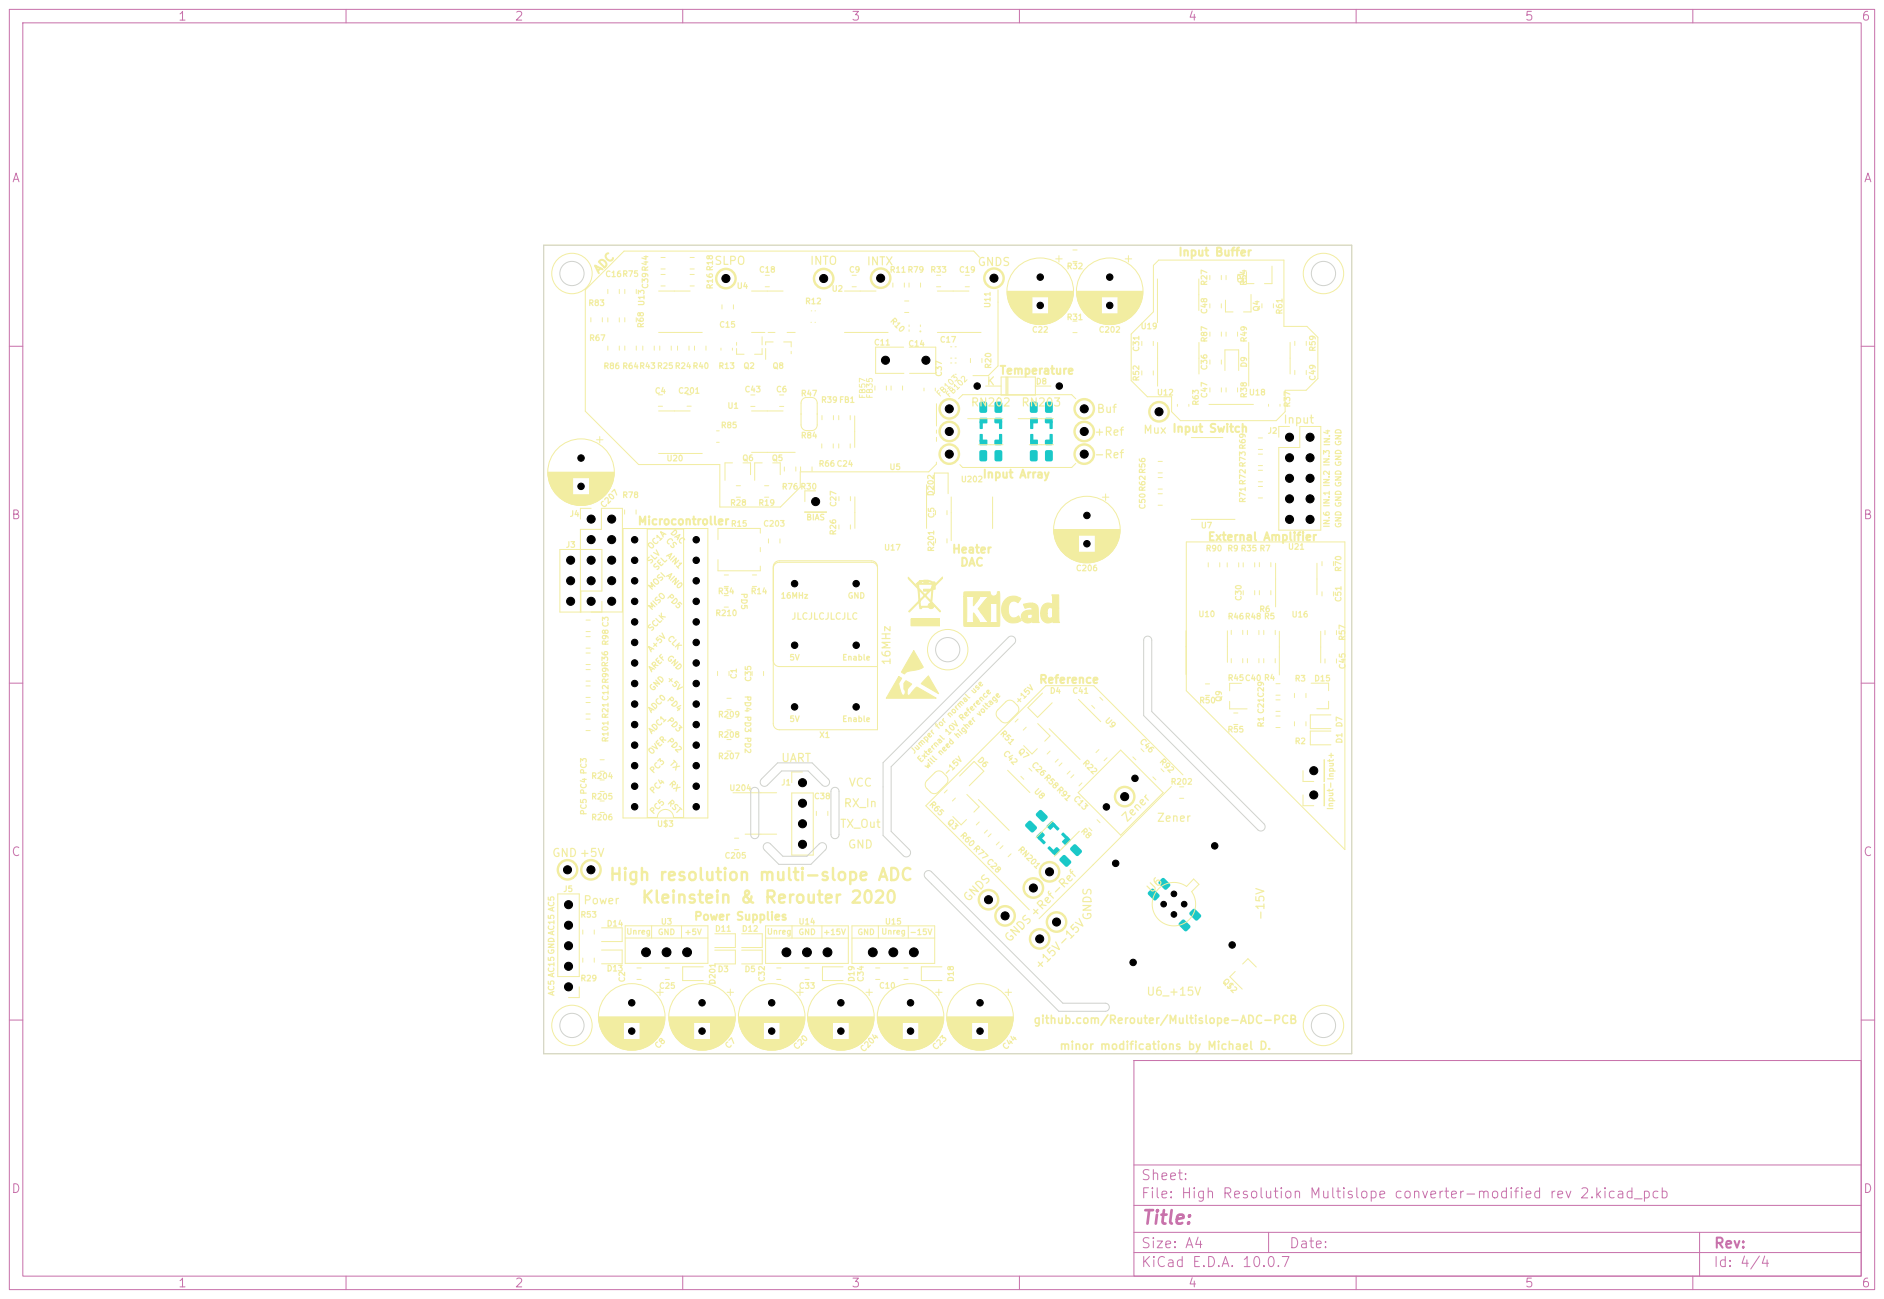
[picture p13: page 4]

Input Buffer External Amplifier ADC

High resolution multi-slope ADC

Sheet:
File: High Resolution Multislope converter-modified rev 2.kicad_pcb
Title:
