Multi-slope-ADC/PCB/High Resolution Multislope converter-modified rev 2.kicad_pcb

## KiCad design High Resolution Multislope converter-modified rev 2.kicad_pcb (2026-10-18)

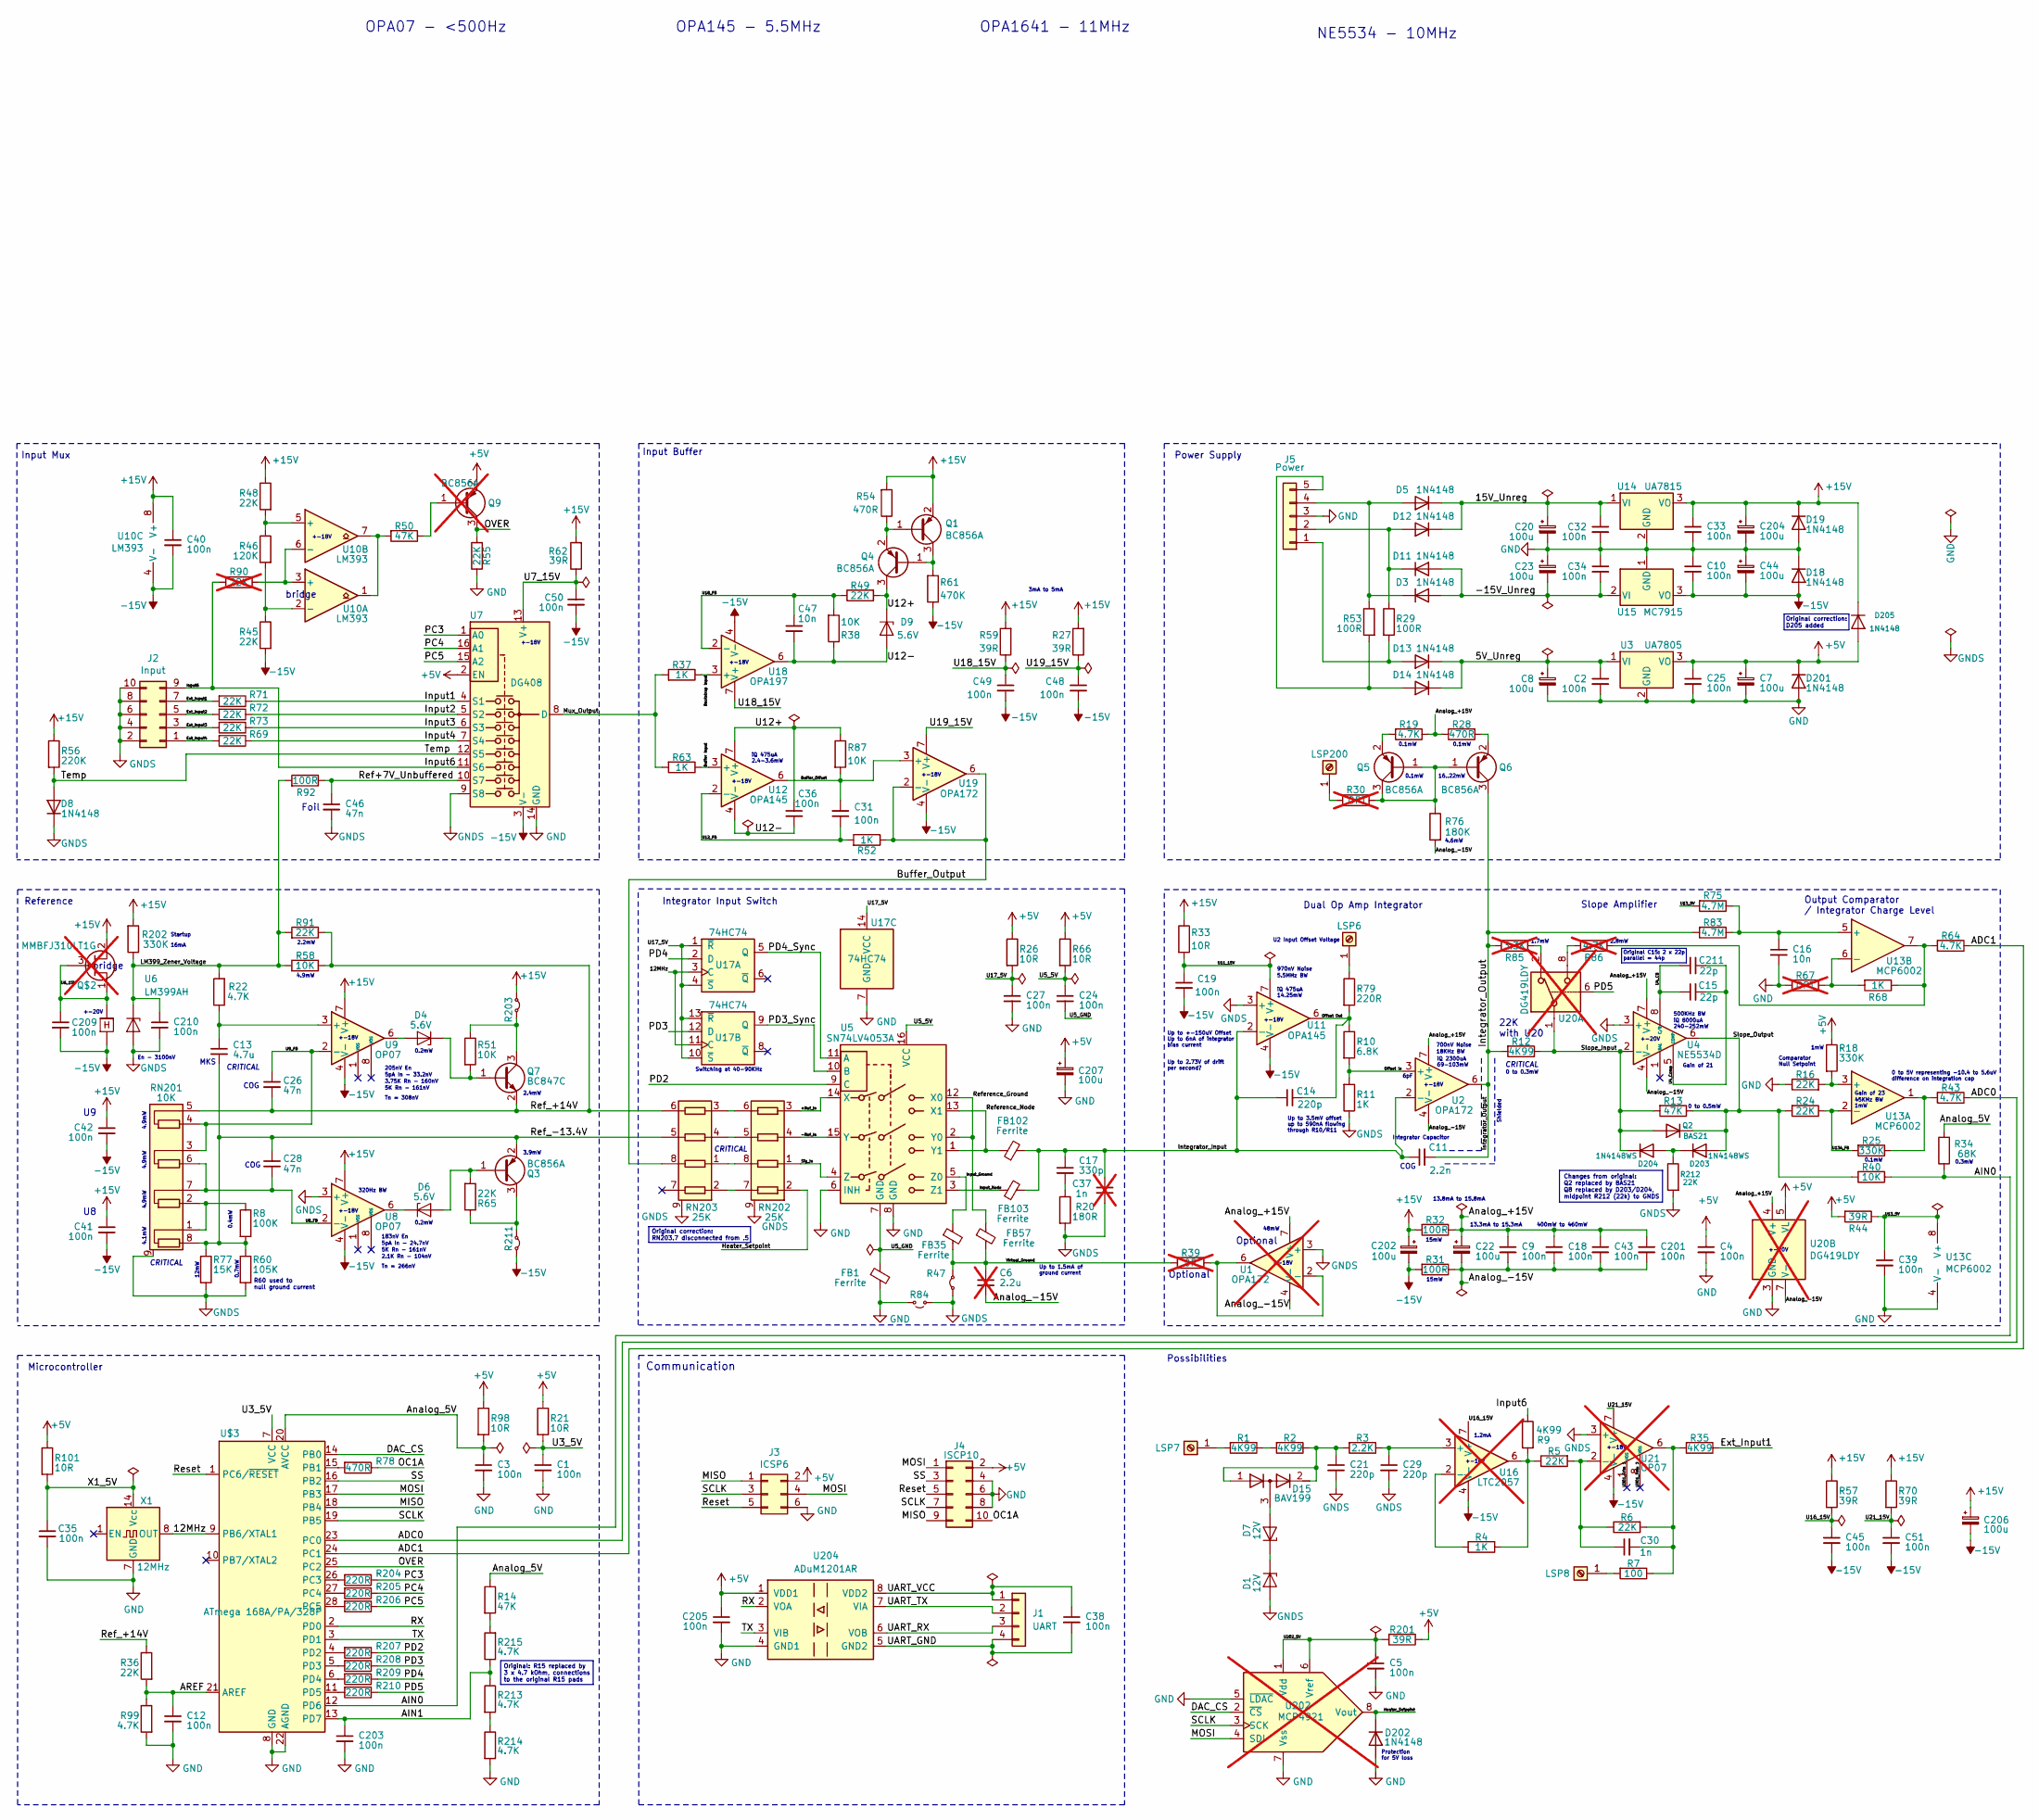
[picture p14: schematic High Resolution Multislope converter-modified rev 2.kicad_sch, Multislope ADC - Original (before 2026 mods)]

Parts:
C1, C2, C3, C4, C5, C9, C10, C12, C18, C19, C24, C25, C27, C32, C33, C34, C35, C36, C38, C39, C40, C41, C42, C43, C45, C48, C49, C50, C51, C201, C203, C205, C209, C210: 100n; C_0805_2012Metric; Manufacturer Part Number 08055C104KAT2A
C6: 2.2u; C_0805_2012Metric; Manufacturer Part Number CL21B225KAFNNNE; not fitted
C7, C8, C20, C22, C23, C44, C202, C204, C206, C207: 100u; CP_Radial_D8.0mm_P3.50mm; Manufacturer Part Number EEU-EB1J101
C11: 2.2n; C_0805_2012Metric; Manufacturer Part Number C2012C0G1H222J085AA
C13: 4.7u; C_Rect_L7.2mm_W7.2mm_P5.00mm_FKS2_FKP2_MKS2_MKP2; Manufacturer Part Number MKS2C044701M00KSSD
C14, C21, C29: 220p; C_0805_2012Metric; Manufacturer Part Number CL21C221JBANNNC
C15, C211: 22p; C_0805_2012Metric; Manufacturer Part Number CL21C220JBANNNC
C16, C47: 10n; C_0805_2012Metric; Manufacturer Part Number CGA4C2C0G1H103J060AA
C17: 330p; C_0805_2012Metric; Manufacturer Part Number C0805C331J5GACTU
C26, C28, C46: 47n; C_0805_2012Metric; Manufacturer Part Number C0805C473K3GECAUTO
C30: 1n; C_0805_2012Metric; Manufacturer Part Number 885012007063
C31: 100n; C_0805_2012Metric; Manufacturer Part Number C0805C473K3GECAUTO
C37: 1n; C_0805_2012Metric; Manufacturer Part Number 885012007063; not fitted
D1, D7: 12V; D_SOD-323; Manufacturer Part Number DDZ12CSF-7
D3, D5, D8, D11, D12, D13, D14, D18, D19, D201, D202: 1N4148; D_SOD-323; Manufacturer Part Number 1N4148WS
D4, D6, D9: 5.6V; D_SOD-323; Manufacturer Part Number MM3Z5V6ST1G
D15: BAV199; SOT-23; Manufacturer Part Number BAV199LT1G
D203, D204: 1N4148WS; Manufacturer Part Number 1N4148WS
D205: 1N4148; Manufacturer Part Number 1N4148
FB1, FB35, FB57, FB102, FB103: Ferrite; L_0805_2012Metric; Manufacturer Part Number MMZ2012Y152BT000
J1: UART; PinHeader_1x04_P2.54mm_Vertical
J2: Input; PinHeader_2x05_P2.54mm_Vertical
J3: ICSP6; PinHeader_2x03_P2.54mm_Vertical
J4: ISCP10; PinHeader_2x05_P2.54mm_Vertical
J5: Power; PinHeader_1x05_P2.54mm_Vertical
LSP6: INTX; PinHeader_1x01_P2.54mm_Vertical
LSP7: Input+; PinHeader_1x01_P2.54mm_Vertical
LSP8: Input-; PinHeader_1x01_P2.54mm_Vertical
LSP200: BIAS; PinHeader_1x01_P2.54mm_Vertical
Q1, Q3, Q4, Q5, Q6: BC856A; SOT-23; Manufacturer Part Number BC856A,215
Q2: BAS21; SOT-23; Manufacturer Part Number BAS21HMFHT116
Q7: BC847C; SOT-23; Manufacturer Part Number BC847CLT1G
Q9: BC856A; SOT-23; Manufacturer Part Number BC856A,215; not fitted
Q$2: MMBFJ310LT1G; SOT-23; Manufacturer Part Number MMBFJ310LT1G; not fitted
R1, R2, R9, R12, R35: 4K99; R_0805_2012Metric; Manufacturer Part Number RR1220P-4991-D-M
R3: 2.2K; R_0805_2012Metric; Manufacturer Part Number RR1220P-222-D
R4, R11, R37, R52, R63, R68: 1K; R_0805_2012Metric; Manufacturer Part Number RR1220P-102-D
R5, R6, R16, R24, R36, R45, R48, R49, R55, R65, R69, R71, R72, R73, R91: 22K; R_0805_2012Metric; Manufacturer Part Number RR1220P-223-D
R7: 100; R_0805_2012Metric; Manufacturer Part Number RR1220P-101-D
R8: 100K; R_0805_2012Metric; Manufacturer Part Number RR1220P-104-D
R10: 6.8K; R_0805_2012Metric; Manufacturer Part Number RR1220P-682-D
R13, R14, R50: 47K; R_0805_2012Metric; Manufacturer Part Number RR1220P-473-D
R18, R25, R202: 330K; R_0805_2012Metric; Manufacturer Part Number RR1220P-334-D
R19, R22, R43, R64, R99: 4.7K; R_0805_2012Metric; Manufacturer Part Number RR1220P-472-D
R20: 180R; R_0805_2012Metric; Manufacturer Part Number RR1220P-181-D
R21, R26, R33, R66, R98, R101: 10R; R_0805_2012Metric; Manufacturer Part Number RR1220Q-100-D
R27, R44, R57, R59, R62, R70, R201: 39R; R_0805_2012Metric; Manufacturer Part Number RR1220Q-390-D
R28, R54, R78: 470R; R_0805_2012Metric; Manufacturer Part Number RR1220P-471-D
R29, R31, R32, R53, R92: 100R; R_0805_2012Metric; Manufacturer Part Number RR1220P-101-D
R30, R67: OPT; R_0805_2012Metric; not fitted
R34: 68K; R_0805_2012Metric; Manufacturer Part Number RR1220P-683-D
R38, R40, R51, R58, R87: 10K; R_0805_2012Metric; Manufacturer Part Number RR1220P-103-D
R39: 0R; R_0805_2012Metric; not fitted
R46: 120K; R_0805_2012Metric; Manufacturer Part Number RR1220P-124-D
R47, R203, R211: Jumper (closed); SolderJumper-2_P1.3mm_Open_RoundedPad1.0x1.5mm
R56: 220K; R_0805_2012Metric; Manufacturer Part Number RR1220P-224-D
R60: 105K; R_0805_2012Metric; Manufacturer Part Number RR1220P-1053-D-M
R61: 470K; R_0805_2012Metric; Manufacturer Part Number RR1220P-474-D
R75, R83: 4.7M; R_0805_2012Metric; Manufacturer Part Number GWCR0805-4M7FT5
R76: 180K; R_0805_2012Metric; Manufacturer Part Number RR1220P-184-D
R77: 15K; R_0805_2012Metric; Manufacturer Part Number RR1220P-153-D
R79, R204, R205, R206, R207, R208, R209, R210: 220R; R_0805_2012Metric; Manufacturer Part Number RR1220P-221-D
R84: Jumper (open); SolderJumper-2_P1.3mm_Open_RoundedPad1.0x1.5mm
R85: 3.3K; R_0805_2012Metric; Manufacturer Part Number RR1220P-332-D; not fitted
R86: 4.7K; R_0805_2012Metric; Manufacturer Part Number RR1220P-472-D; not fitted
R90: 22K; R_0805_2012Metric; Manufacturer Part Number RR1220P-223-D; not fitted
R212: 22K
R213, R214, R215: 4.7K
RN201: 10K; MSOP-8_3x3mm_P0.65mm; Manufacturer Part Number MORNTA1002AT5
RN202, RN203: 25K; MSOP-8_3x3mm_P0.65mm; Manufacturer Part Number MORNTA2502AT5
U1: OPA172; SOIC-8_3.9x4.9mm_P1.27mm; Manufacturer Part Number OPA172IDR; not fitted
U2, U19: OPA172; SOIC-8_3.9x4.9mm_P1.27mm; Manufacturer Part Number OPA172IDR
U3: UA7805; TO-220-3_Vertical; Manufacturer Part Number UA7805CKCT
U4: NE5534D; SOIC-8_3.9x4.9mm_P1.27mm; Manufacturer Part Number NE5534DRE4
U5: SN74LV4053A; SOIC-16_3.9x9.9mm_P1.27mm; Manufacturer Part Number SN74LV4053ADR
U6: LM399AH; TO-46-4; Manufacturer Part Number LM399AH
U7: DG408; SOIC-16_3.9x9.9mm_P1.27mm; Manufacturer Part Number DG408DY-E3
U8, U9: OP07; SOIC-8_3.9x4.9mm_P1.27mm; Manufacturer Part Number OP07CDR
U10: LM393; SOIC-8_3.9x4.9mm_P1.27mm; Manufacturer Part Number LM393ADRG4
U11, U12: OPA145; SOIC-8_3.9x4.9mm_P1.27mm; Manufacturer Part Number OPA145IDR
U13: MCP6002; SOIC-8_3.9x4.9mm_P1.27mm; Manufacturer Part Number MCP6002T-I/SN
U14: UA7815; TO-220-3_Vertical; Manufacturer Part Number UA7815CKCT
U15: MC7915; TO-220-3_Vertical; Manufacturer Part Number MC7915ACTG
U16: LTC2057; SOIC-8_3.9x4.9mm_P1.27mm; Manufacturer Part Number LTC2057IS8#PBF; not fitted
U17: 74HC74; SOIC-14_3.9x8.7mm_P1.27mm; Manufacturer Part Number 74HC74D,653
U18: OPA197; SOIC-8_3.9x4.9mm_P1.27mm; Manufacturer Part Number OPA197IDR
U20: DG419LDY; SOIC-8_3.9x4.9mm_P1.27mm; Manufacturer Part Number DG419LDY+; not fitted
U21: OP07; SOIC-8_3.9x4.9mm_P1.27mm; Manufacturer Part Number OP07CDR; not fitted
U202: MCP4921; SOIC-8_3.9x4.9mm_P1.27mm; Manufacturer Part Number MCP4921-E/SN; not fitted
U204: ADuM1201AR; SOIC-8_3.9x4.9mm_P1.27mm; Manufacturer Part Number ADUM1201ARZ-RL7
U$3: ATmega 168A/PA/328P; DIP-28_W7.62mm_Socket_LongPads; Manufacturer Part Number ATmega48A/48PA/88A/88PA/168A/168PA/328/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
X1: 12MHz; Oscillator_DIP-14

Connections:
+5V: C4.1, C7.1, C25.1, C205.1, C207.1, D201.1 (K), D205.2 (A), J3.2, J4.2, Q9.2 (E), R18.1, R21.1, R26.1, R44.2, R66.1, R98.1, R101.1, R201.1, U3.3 (VO), U7.2 (EN), U20.5 (VL), U204.1 (VDD1); also elsewhere on the board
+15V: C33.1, C40.1, C41.1, C42.1, C202.1, C204.1, C206.1, D19.1 (K), D205.1 (K), Q1.2 (E), Q$2.2 (S), R27.2, R32.2, R33.1, R48.1, R54.2, R56.1, R57.1, R59.2, R62.2, R70.1, R202.2, R203.2 (B), U8.7 (V+), U9.7 (V+), U10.8 (V+), U14.3 (VO); also elsewhere on the board
-15V: C10.2, C19.2, C40.2, C41.2, C42.2, C44.2, C45.2, C48.2, C49.2, C50.2, C51.2, C202.2, C206.2, C209.2, D18.2 (A), R31.2, R45.2, R61.1, R211.2 (B), U6.4 (-), U7.3 (V-), U8.4 (V-), U9.4 (V-), U10.4 (V-), U11.4 (V-), U15.3 (VO), U16.4 (V-), U18.4 (V-), U19.4 (V-), U21.4 (V-); also elsewhere on the board
/5V_Unreg: C2.1, C8.1, D13.1 (K), D14.1 (K), U3.1 (VI)
/15V_Unreg: C20.1, C32.1, D5.1 (K), D12.1 (K), U14.1 (VI)
/16MHz: U17.3 (C), U17.11 (C), U$3.9 (PB6/XTAL1), X1.8 (OUT)
/+Ref_In: RN202.3 (R3.1), U5.14 (X); also elsewhere on the board
/-15V_Unreg: C23.2, C34.2, D3.2 (A), D11.2 (A), U15.2 (VI)
/-Ref_In: RN202.4 (R4.1), U5.15 (Y); also elsewhere on the board
/ADC0: R43.1, U$3.23 (PC0)
/ADC1: R64.1, U$3.24 (PC1)
/AIN0: R34.1, R40.1, U$3.12 (PD6)
/AIN1: C203.1, R213.1, R215.1, U$3.13 (PD7); also elsewhere on the board
/AREF: C12.1, R36.2, R99.1, U$3.21 (AREF)
/Analog_5V: C3.1, R14.1, R34.2, R98.2, U$3.20 (AVCC)
/Analog_+15V: C9.1, C18.1, C22.1, C43.1, C201.1, R19.1, R28.1, R32.1, U1.7 (V+), U2.7 (V+), U4.7 (V+), U20.4 (V+)
/Analog_-15V: C6.2, C9.2, C18.2, C22.2, C43.2, C201.2, R31.1, R76.2, U1.4 (V-), U2.4 (V-), U4.4 (V-), U20.7 (V-)
/Bootstrap Input: R37.1, U18.3 (+)
/Buffer Input: R63.1, U12.3 (+)
/Buffer_Offset: C31.2, R87.2, U12.6, U19.3 (+)
/Buffer_Output: R52.1, RN203.8 (R1.2), U19.2 (-), U19.6; also elsewhere on the board
/DAC_CS: U202.2 (~CS), U$3.14 (PB0)
/Ext_Input1: J2.7, R35.1, R71.2
/Ext_Input2: J2.5, R72.2
/Ext_Input3: J2.3, R73.2
/Ext_Input4: J2.1, R69.2
/Heater_Setpoint: D202.1 (K), RN202.2 (R2.1), U202.8 (Vout); also elsewhere on the board
/Input1: R71.1, U7.4 (S1)
/Input2: R72.1, U7.5 (S2)
/Input3: R73.1, U7.6 (S3)
/Input4: R69.1, U7.7 (S4)
/Input6: J2.9, R9.1, R90.2, U7.11 (S6)
/Input_Ground: FB35.1, U5.5 (Z0)
/Input_Node: FB103.1, U5.3 (Z1)
/Integrator_Input: C11.1, C14.1, C17.1, C37.1, FB102.2, FB103.2, U2.2 (-), U11.2 (-); also elsewhere on the board
/Integrator_Output: C11.2, Q6.3 (C), R12.2, R83.2, R85.2, U2.6; also elsewhere on the board
/LM399_Zener_Voltage: C210.1, R22.2, R58.2, R91.2, R92.2, R202.1, U6.1 (K); also elsewhere on the board
/MISO: J3.1, J4.9, U$3.18 (PB4)
/MOSI: J3.4, J4.1, U202.4 (SDI), U$3.17 (PB3)
/Mux_Output: R37.2, R63.2, U7.8 (D); also elsewhere on the board
/OC1A: J4.10, R78.1
/OVER: Q9.3 (C), R55.2, U$3.25 (PC2)
/Offset In: R10.2, R11.2, U2.3 (+)
/Offset Out: C14.2, R10.1, R79.2, U11.6
/PC3: R204.1, U7.1 (A0)
/PC4: R205.1, U7.16 (A1)
/PC5: R206.1, U7.15 (A2)
/PD2: R207.1, U5.9 (C)
/PD3: R208.1, U17.12 (D)
/PD3_Sync: U5.10 (B), U17.9 (Q)
/PD4: R209.1, U17.2 (D)
/PD4_Sync: U5.11 (A), U17.5 (Q)
/PD5: R210.1, U20.6
/RX: U204.2 (VOA), U$3.2 (PD0)
/Ref+7V_Unbuffered: C46.1, R92.1, U7.10 (S7)
/Ref_+14V: C26.2, Q7.2 (E), R36.1, R58.1, R91.1, RN201.5 (R4.2), RN203.6 (R3.2); also elsewhere on the board
/Ref_-13.4V: C13.2, C28.2, Q3.2 (E), R8.2, R60.1, R77.1, RN201.8 (R1.1), RN203.5 (R4.2), RN203.7 (R2.2); also elsewhere on the board
/Reference_Ground: FB57.1, U5.2 (Y0), U5.12 (X0)
/Reference_Node: FB102.1, U5.1 (Y1), U5.13 (X1)
/Reset: J3.5, J4.5, U$3.1 (PC6/~RESET)
/SCLK: J3.3, J4.7, U202.3 (SCK), U$3.19 (PB5)
/SS: J4.3, U$3.16 (PB2)
/Sig_In: RN202.1 (R1.1), U5.4 (Z); also elsewhere on the board
/Slope_Input: D204.1 (K), Q2.1 (A), Q2.2 (NC), R12.1, R13.2, U4.2 (-), U20.1; also elsewhere on the board
/Slope_Output: D203.2 (A), Q2.3 (K), R13.1, R24.2, R40.2, U4.6; also elsewhere on the board
/TX: U204.3 (VIB), U$3.3 (PD1)
/Temp: D8.2 (A), R56.2, U7.12 (S5)
/U4_Bal: U4.1 (BAL)
/U4_CB: C15.1, C211.1, U4.8 (C/B)
/U4_Comp: C15.2, C211.2, U4.5 (COMP)
/U5_5V: C24.1, R66.2, U5.16 (VCC)
/U5_GND: C24.2, FB1.1, U5.7 (GND)
/U6_15V: C209.1, Q$2.1 (D), Q$2.3 (G), U6.3 (+)
/U7_15V: C50.1, R62.1, U7.13 (V+)
/U8_FB: C28.1, RN201.6 (R3.1), RN201.7 (R2.2), U8.2 (-); also elsewhere on the board
/U8_Trim 1: U8.1 (VOS)
/U8_Trim 2: U8.8 (VOS)
/U9_FB: C26.1, RN201.3 (R3.2), RN201.4 (R4.1), U9.2 (-); also elsewhere on the board
/U9_Trim 1: U9.1 (VOS)
/U9_Trim 2: U9.8 (VOS)
/U11_15V: C19.1, R33.2, U11.7 (V+)
/U12+: C36.1, D9.1 (K), Q4.3 (C), R49.2, R87.1, U12.7 (V+)
/U12-: C36.2, C47.2, D9.2 (A), R38.1, U12.4 (V-), U18.6
/U12_FB: C31.1, R52.2, U12.2 (-)
/U13A_FB: R24.1, R25.2, U13.2 (-)
/U13_5V: C39.1, R44.1, R75.2, U13.8 (V+)
/U16_15V: C45.1, R57.2, U16.7 (V+)
/U17_5V: C27.1, R26.2, U17.1 (~R), U17.4 (~S), U17.10 (~S), U17.13 (~R), U17.14 (VCC)
/U18_15V: C49.1, R59.1, U18.7 (V+)
/U18_FB: C47.1, R38.2, R49.1, U18.2 (-)
/U19_15V: C48.1, R27.1, U19.7 (V+)
/U21_15V: C51.1, R70.2, U21.7 (V+)
/U202_5V: C5.1, R201.2, U202.1 (Vdd), U202.6 (Vref)
/U301_Trim 1: U21.1 (VOS)
/U301_Trim 2: U21.8 (VOS)
/U$3_5V: C1.1, R21.2, U$3.7 (VCC)
/UART_GND: C38.2, J1.4, U204.5 (GND2)
/UART_RX: J1.3, U204.6 (VOB)
/UART_TX: J1.2, U204.7 (VIA)
/UART_VCC: C38.1, J1.1, U204.8 (VDD2)
/Virtual_Ground: C6.1, FB35.2, FB57.2, R39.2, R47.1 (A)
/X1_5V: C35.1, R101.2, X1.14 (Vcc)
/X1_Enable: X1.1 (EN)
GND: C1.2, C2.2, C3.2, C4.2, C5.2, C7.2, C8.2, C10.1, C12.2, C16.2, C20.2, C23.1, C25.2, C27.2, C32.2, C33.2, C34.1, C35.2, C39.2, C44.1, C203.2, C204.2, C205.2, C207.2, D18.1 (K), D19.2 (A), D201.2 (A), D202.2 (A), FB1.2, J3.6, J4.4, J4.6, J4.8, J5.3, R16.1, R55.1, R67.2, R84.1 (A), R99.2, R214.2, U3.2 (GND), U5.6 (INH), U5.8 (GND), U7.14 (GND), U13.4 (V-), U14.2 (GND), U15.1 (GND), U17.7 (GND), U20.3 (GND), U202.5 (~LDAC), U202.7 (Vss), U204.4 (GND1), U$3.8 (GND), U$3.22 (AGND), X1.7 (GND); also elsewhere on the board
GNDS: C21.2, C29.2, C37.2, C46.2, C210.2, D1.2 (A), D8.1 (K), J2.2, J2.4, J2.6, J2.8, J2.10, R11.1, R20.2, R47.2 (B), R60.2, R77.2, R84.2 (B), R212.2, RN201.9 (Pad), RN202.9 (Pad), RN203.9 (Pad), U1.3 (+), U4.3 (+), U6.2 (A), U7.9 (S8), U8.3 (+), U11.3 (+), U21.3 (+); also elsewhere on the board
unnamed: C13.1, R22.1, U9.3 (+)
unnamed: C16.1, R75.1, R83.1, U13.5 (+)
unnamed: C17.2, R20.1
unnamed: C21.1, D15.1 (A), D15.2 (K), R2.1, R3.2
unnamed: C29.1, R3.1, U16.3 (+)
unnamed: C30.1, R5.2, R6.1, U21.2 (-)
unnamed: C30.2, R6.2, R7.1, R35.2, U21.6
unnamed: D1.1 (K), D7.1 (K)
unnamed: D3.1 (K), D5.2 (A), J5.4, R53.1
unnamed: D4.1 (K), Q7.1 (B), R51.2
unnamed: D4.2 (A), U9.6
unnamed: D6.1 (K), U8.6
unnamed: D6.2 (A), Q3.1 (B), R65.2
unnamed: D11.1 (K), D12.2 (A), J5.2, R29.1
unnamed: D13.2 (A), J5.1, R29.2
unnamed: D14.2 (A), J5.5, R53.2
unnamed: D7.2 (A), D15.3 (common)
unnamed: D203.1 (K), D204.2 (A), R212.1
unnamed: LSP6.1, R79.1
unnamed: LSP7.1, R1.2
unnamed: LSP8.1, R7.2
unnamed: LSP200.1, R30.2
unnamed: Q1.1 (B), Q4.2 (E), R54.1
unnamed: Q1.3 (C), Q4.1 (B), R61.2
unnamed: Q3.3 (C), R65.1, R211.1 (A)
unnamed: Q5.1 (B), Q5.3 (C), Q6.1 (B), R30.1, R76.1
unnamed: Q5.2 (E), R19.2
unnamed: Q6.2 (E), R28.2
unnamed: Q7.3 (C), R51.1, R203.1 (A)
unnamed: Q9.1 (B), R50.1
unnamed: R1.1, R2.2
unnamed: R4.1, R5.1, R9.2, U16.6
unnamed: R4.2, U16.2 (-)
unnamed 138: R8.1, RN201.1 (R1.2), RN201.2 (R2.1); also elsewhere on the board
unnamed 139: R14.2, R215.2; also elsewhere on the board
unnamed: R16.2, R18.2, U13.3 (+)
unnamed: R25.1, R43.2, U13.1
unnamed: R39.1, U1.2 (-), U1.6
unnamed: R45.1, R46.2, U10.2 (-)
unnamed: R46.1, R48.2, U10.5 (+)
unnamed: R50.2, U10.1, U10.7
unnamed: R64.2, R68.1, R86.1, U13.7
unnamed: R67.1, R68.2, U13.6 (-)
unnamed: R78.2, U$3.15 (PB1)
unnamed: R85.1, U20.2
unnamed: R86.2, U20.8
unnamed: R90.1, U10.3 (+), U10.6 (-)
unnamed: R204.2, U$3.26 (PC3)
unnamed: R205.2, U$3.27 (PC4)
unnamed: R206.2, U$3.28 (PC5)
unnamed: R207.2, U$3.4 (PD2)
unnamed: R208.2, U$3.5 (PD3)
unnamed: R209.2, U$3.6 (PD4)
unnamed: R210.2, U$3.11 (PD5)
unnamed: R213.2, R214.1
unnamed 160: RN202.5 (R4.2), RN203.4 (R4.1); also elsewhere on the board
unnamed 161: RN202.6 (R3.2), RN203.3 (R3.1); also elsewhere on the board
unnamed 162: RN202.7 (R2.2), RN203.2 (R2.1); also elsewhere on the board
unnamed 163: RN202.8 (R1.2), RN203.1 (R1.1); also elsewhere on the board

Notes on the sheet:
Tn = 266nV
+-18V
COG
700nV Noise
Power Supply
1mW
Up to +-150uV Offset Up to 6nA of integrator bias current
0 to 0.3mW
2.4mW
CRITICAL
18KHz BW
Microcontroller
Up to 2.73V of drift per second?
183nV En
Gain of 23
Startup
970nV Noise
Shielded
bridge
0.1mW
+-20V
205nV En
15mW
5pA In - 33.2nV
Slope Amplifier
Input Mux
48mW
22K with U20
0.3mW
5K Rn - 161nV
3.75K Rn - 160nV
Possibilities
OPA07 - <500Hz
4.9mW
iQ 2300uA 69-103mW
Reference
5pA In - 24.7nV
Up to 3.5mV offset up to 590nA flowing through R10/R11
Optional
Input Buffer
R60 used to null ground current
Original correction: RN203.7 disconnected from .5
iQ 8000uA 240-252mW
Switching at 40-90KHz
4.6mW
Original: R15 replaced by 3 x 4.7 kOhm, connections to the original R15 pads
0.4mW
16mA
OPA145 - 5.5MHz
Foil
0 to 0.5mW
45KHz BW
Dual Op Amp Integrator
2.8mW
MKS
13.8mA to 15.8mA
OPA1641 - 11MHz
0.2mW
Original correction: D205 added
Gain of 21
Communication
3mA to 5mA
U2 Input Offset Voltage
Changes from original: Q2 replaced by BAS21 Q8 replaced by D203/D204, midpoint R212 (22k) to GNDS
0.7mW
6pF
Tn = 308nV
12mW
1.7mW
Integrator Input Switch
Comparator Null Setpoint
Integrator Capacitor
Protection for 5V loss
13.3mA to 15.3mA
320Hz BW
NE5534 - 10MHz
En - 3100nV
5.5MHz BW
Output Comparator / Integrator Charge Level
Up to 1.5mA of ground current
Original C15: 2 x 22p parallel = 44p
4.1mW
0 to 5V representing -10.4 to 5.6uV difference on integration cap
16..22mW
2.2mW
500KHz BW
iQ 475uA 2.4-3.6mW
1.2mA
2.1K Rn - 104nV
iQ 475uA 14.25mW
3.9mW
400mW to 460mW

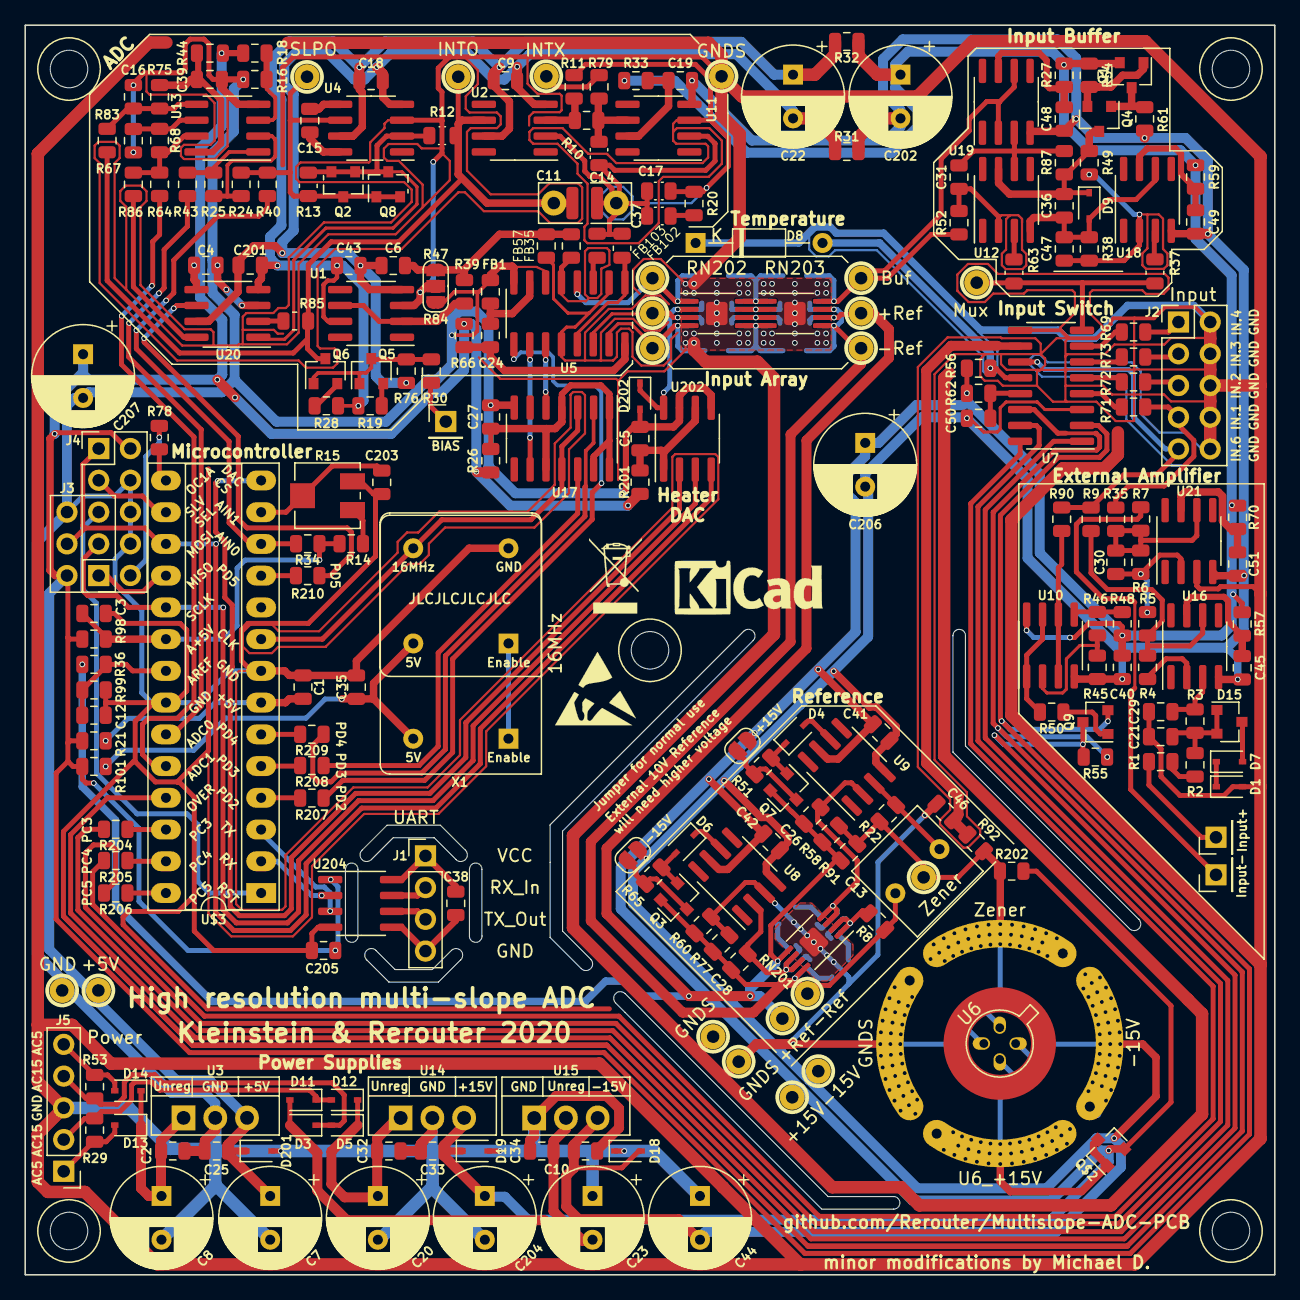
[picture p15: board High Resolution Multislope converter-modified rev 2.kicad_pcb from above]

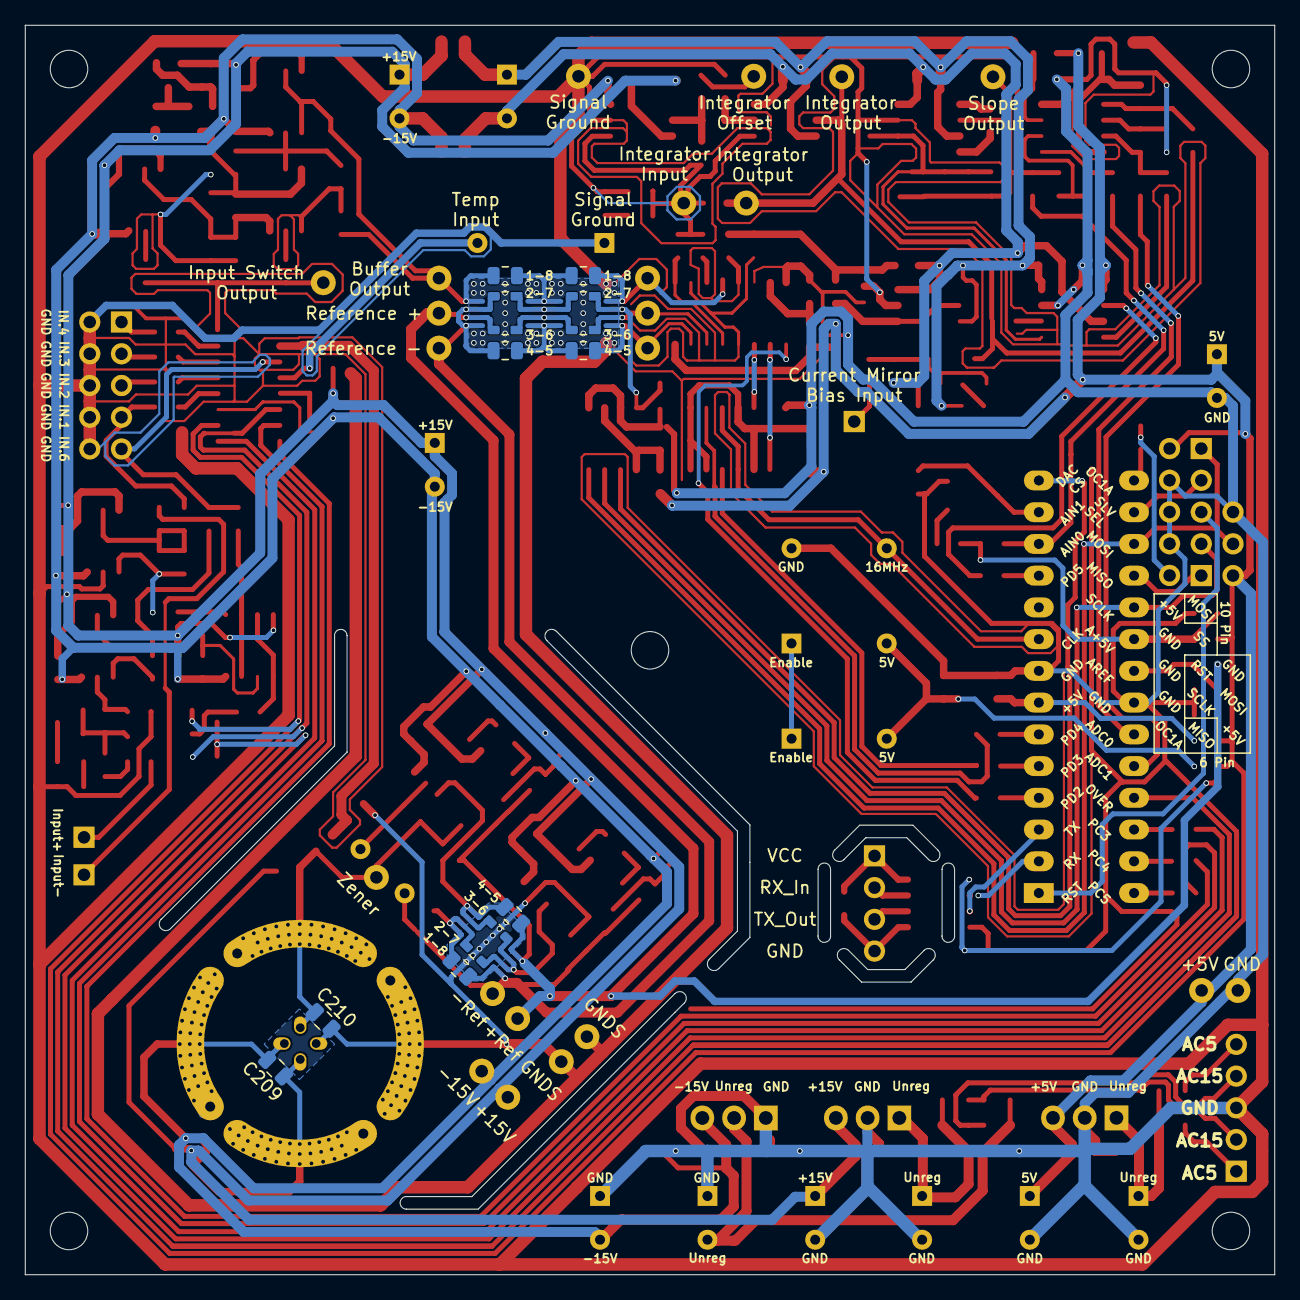
[picture p16: board High Resolution Multislope converter-modified rev 2.kicad_pcb from below]

Board: 2 copper layers, 100.0 x 100.0 mm, 257 parts (14 on the bottom side), 154 nets.

Other parts of the board:
1-8, 1-8#2, 2-7, 2-7#2, 2-7#3, 3-6, 3-6#2, 3-6#3, 4-5, 4-5#3: 20K; R_0805_2012Metric
1-8#3, 4-5#2: 10K; R_0805_2012Metric
+5V, +15V: Pin_Header_Straight_1x01_Pitch2.54mm
+Ref: Pin_Header_Straight_1x01_Pitch2.54mm
+Ref#2, +Ref#3: Pin_Header_Straight_1x01_Pitch2.54mm
-15V: Pin_Header_Straight_1x01_Pitch2.54mm
-Ref: Pin_Header_Straight_1x01_Pitch2.54mm
-Ref#2, -Ref#3: Pin_Header_Straight_1x01_Pitch2.54mm
Buf: Pin_Header_Straight_1x01_Pitch2.54mm
Buf#2: Pin_Header_Straight_1x01_Pitch2.54mm
C11#2: 2.2n; C_Rect_L7.2mm_W3.0mm_P5.00mm_FKS2_FKP2_MKS2_MKP2
GND: Pin_Header_Straight_1x01_Pitch2.54mm
GNDS: Pin_Header_Straight_1x01_Pitch2.54mm
GNDS#2, GNDS#3: Pin_Header_Straight_1x01_Pitch2.54mm
INTO: Pin_Header_Straight_1x01_Pitch2.54mm
Mux: Pin_Header_Straight_1x01_Pitch2.54mm
Q8: BC847; SOT-23
R15: 10K; Potentiometer_Vishay_TS53YJ_Vertical
SLPO: Pin_Header_Straight_1x01_Pitch2.54mm
Zener: Pin_Header_Straight_1x01_Pitch2.54mm

Their connections:
+5V: +5V.1; also elsewhere on the board
+15V: +15V.1; also elsewhere on the board
-15V: -15V.1; also elsewhere on the board
/+Ref_In: 3-6.1, +Ref#2.1; also elsewhere on the board
/-Ref_In: 4-5.1, -Ref#2.1; also elsewhere on the board
/AIN1: R15.2; also elsewhere on the board
/Buffer_Output: 1-8#2.2, Buf#2.1; also elsewhere on the board
/Heater_Setpoint: 2-7.1; also elsewhere on the board
/Integrator_Input: C11#2.1; also elsewhere on the board
/Integrator_Output: C11#2.2, INTO.1; also elsewhere on the board
/LM399_Zener_Voltage: Zener.1; also elsewhere on the board
/Mux_Output: Mux.1; also elsewhere on the board
/Ref_+14V: 3-6#2.2, 4-5#2.2, +Ref.1, +Ref#3.1; also elsewhere on the board
/Ref_-13.4V: 1-8#3.2, 2-7#3.2, 4-5#3.2, -Ref.1, -Ref#3.1; also elsewhere on the board
/Sig_In: 1-8.1, Buf.1; also elsewhere on the board
/Slope_Input: Q8.3; also elsewhere on the board
/Slope_Output: Q8.1, Q8.2, SLPO.1; also elsewhere on the board
/U8_FB: 2-7#2.2, 3-6#3.2; also elsewhere on the board
/U9_FB: 3-6#3.1, 4-5#2.1; also elsewhere on the board
GND: GND.1, R15.1; also elsewhere on the board
GNDS: GNDS.1, GNDS#2.1, GNDS#3.1; also elsewhere on the board
unnamed 138: 1-8#3.1, 2-7#2.1; also elsewhere on the board
unnamed 139: R15.3; also elsewhere on the board
unnamed 160: 4-5.2, 4-5#3.1; also elsewhere on the board
unnamed 161: 3-6.2, 3-6#2.1; also elsewhere on the board
unnamed 162: 2-7.2, 2-7#3.1; also elsewhere on the board
unnamed 163: 1-8.2, 1-8#2.1; also elsewhere on the board
